dario0603/power_supply/Relazione/Relazione Costruzioni.odt

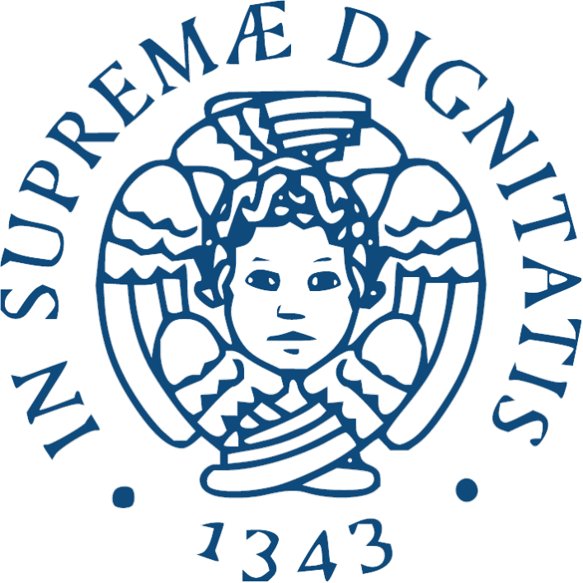
[picture p5: figure]

Università degli studi di Pisa

Dipartimento di ingegneria dell’informazione

Corso di laurea ingegneria elettronica

Progettazione di un alimentatore

da banco stabilizzato

Studenti:

Giorgio De Stefano

Dario Aliberti

Indice

Introduzione

- Presentazione del progetto
- Obbiettivi del lavoro

Analisi del circuito alimentatore

Analisi del circuito raddrizzatore

- Circuito raddrizzatore e filtro
- Raddrizzatore a doppia semi-onda
- Filtro capacitivo
- Calcolo capacità raddrizzatore a doppia semi-onda
- Dimensionamento filtro capacitivo
- Simulazione circuito raddrizzatore e filtro

Analisi del circuito regolatore

- Circuito regolatore con feedback di corrente
- Efficienza energetica
- Non idealità nel regolatore di tensione
- Modalità tracking
- Simulazione circuito regolatore di tensione
- Dimensionamento circuito regolatore di tensione

Dimensionamento del circuito alimentatore

- Alimentazioni ausiliarie
- Taratura circuito di tracking

Analisi del circuito di lettura di tensione e corrente

Voltmetro con fondo-scala variabile

- Voltmetro a partitore resistivo
- Voltmetro a guadagno variabile
- Confronto circuiti voltmetro

Amperometro con fondo-scala variabile

- Amperometro con convertitore corrente tensione
- Amperometro con resistore di shunt

Scelta circuiti di misura

- Dimensionamento voltmetro
- Dimensionamento amperometro

Taratura circuiti

- Taratura circuito voltmetro
- Taratura circuito amperometro

Analisi guasti e non idealità circuito

- Calcolo capacità di accoppiamento piste
- Analisi signal integrity
- Simulazioni signal integrity
- Compilazione FMEA

Conclusione

- Difficoltà incontrate
- Possibili migliorie di progetto
- Conclusioni

Analisi del circuito alimentatore

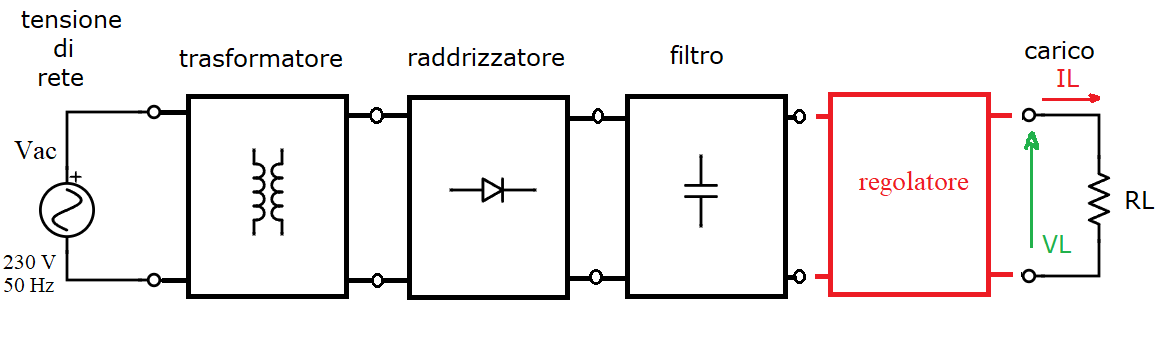
[picture p6: figure]

Il circuito dell’alimentatore è diviso in quattro blocchi principali

- Il trasformatore che si occupa di abbassare l’ampiezza della tensione sinusoidale di rete mantenendo costante la potenza elettrica in ingresso e in uscita.
- Il raddrizzatore che modifica la forma d’onda sinusoidale in uscita dal trasformatore in una forma d’onda unidirezionale (sempre positiva) pulsante.
- Il filtro che rimuove le componenti frequenziali indesiderate, quindi tutte le armoniche a frequenza non nulla.
- Il regolatore che prende in ingresso la tensione continua raddrizzata dal filtro e manda in uscita una tensione continua regolata in base alle esigenze dell’utente.

Analisi del circuito raddrizzatore

Circuito raddrizzatore e filtro

Il circuito raddrizzatore ha il compito di rendere unidirezionale una fonte di tensione alternata.

Esistono diversi tipi di raddrizzatori, tuttavia i più comuni sono due: il raddrizzatore a singola semi-onda e il raddrizzatore a doppia semi-onda.

Raddrizzatore a doppia semi-onda

Il raddrizzatore a doppia semi-onda è formato da quattro diodi che entrano in conduzione a coppie alterne in modo da far passare la corrente in un verso quando la tensione in ingresso è positiva e nel verso opposto quando è negativa.

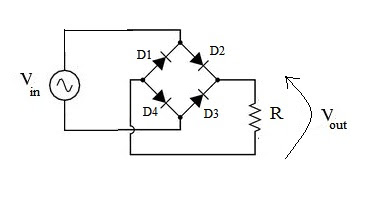
[picture p7: figure]

I diodi D2 e D4 entrano in conduzione quando Vin è positiva e supera la soglia di conduzione dei due diodi, quindi 2VDon ≈ 1.4V, i diodi D1 e D3 invece entrano in conduzione quando Vin è negativa e scende sotto il valore di 2VDon quindi quando Vin < -2VDon ≈ -1.4V.

Quando conducono i diodi D2 e D4 la corrente sul carico scorre in un verso, mentre quando conducono i diodi D1 e D3 la corrente scorre sul carico nel verso opposto in modo da avere una tensione sul carico sempre positiva (o negativa dipende da dove viene collocato il riferimento di massa).

alignl size 16 {stack { {V} rsub {o} = {V} rsub {i} − 2 {V} rsub {Don} ≃ {V} rsub {i} − 1.4 V ~ ~ ~ se {V} rsub {i} ≥ 2 {V} rsub {Don} } } newline
alignl size 16 { {stack { {V} rsub {o} = - {V} rsub {i} + 2 {V} rsub {Don} ≃ - {V} rsub {i} + 1.4 V ~ ~ ~ se {V} rsub {i} <= -2 {V} rsub {Don} } } } newline
alignl size 16 { {stack { {V} rsub {o} = 0 V ~ ~ ~ se -2 {V} rsub {Don} < {V} rsub {i} < 2 {V} rsub {Don} } } }

La forma d’onda del segnale Vout sarà quindi

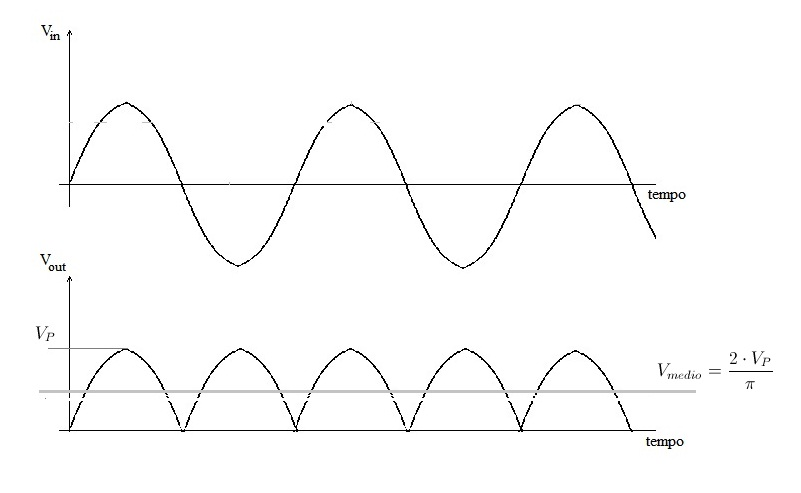
[picture p8: figure]

Il valor medio sarà all’incirca il doppio rispetto al raddrizzatore a singola semi-onda, infatti

size 16 { {V} rsub {m} = {int from {a} to {b} {left ({V} rsub {p} sin left (ω t right ) − {V} rsub {Don} right ) dt}} over {{2 π} over {ω}} ≃ {int from {0} to {{2 π} over {ω}} {{V} rsub {p} sin left (ω t right ) dt}} over {{2 π} over {ω}} = {left none {{− {V} rsub {p}} over {ω} cos left (ω t right )} over {{2 π} over {ω}} right rline} rsub {0} rsup {{2 π} over {ω}} = {2 {V} rsub {p}} over {π} }

Il valore efficace sarà invece

size 16 { V_eff = sqrt { { { int from { a } to { b } { (V_p sin ( %omega t ) - V_{ Don } ) ^ 2 dt } } } over { { 2 %pi } over %omega } } simeq
{ sqrt { int from { 0 } to { { 2 %pi } over %omega } { V_p^2 sin ( %omega t ) ^ 2 dt } over { { 2 %pi } over %omega } } } } newline
size 16 { V_eff simeq evaluate { V_p sqrt { { { %omega } over { 2 %pi } } cdot { { 2 %omega t - sin ( 2 %omega t ) } over { 4 %omega } } } } from { 0 } to { { 2 %pi } over %omega } =
{ V_p } over { sqrt { 2 }} }

quindi il fattore di forma complessivo sarà più grande rispetto al raddrizzatore a singola semi-onda.

size 16 { K_f = V_eff over V_m simeq { V_p over sqrt { 2 } } over { 2 V_p over %pi } = %pi over sqrt 2 simeq 2.22}

Filtro capacitivo

Il filtro capacitivo consiste in un filtro passa basso formato da un condensatore connesso in parallelo all’uscita del circuito raddrizzatore che ha il compito di caricarsi molto rapidamente, tramite i diodi del circuito raddrizzatore, e scaricarsi più lentamente possibile, sul carico.

Per il dimensionamento del filtro capacitivo bisogna scegliere una capacità abbastanza elevata da scaricarsi poco durante il periodo in cui la tensione raddrizzata è bassa, ma abbastanza piccola da non far scorrere troppa corrente sul circuito raddrizzatore durante le fasi di carica.

Calcolo capacità raddrizzatore a doppia semi-onda

Ipotizzando di trascurare l’impedenza di sorgente, la tensione d’uscita avrà, a regime, un andamento periodico.

All’interno di un periodo la tensione di uscita coinciderà con la tensione in ingresso nell’intervallo in cui il diodo conduce e coinciderà con la tensione di scarica del condensatore quando il diodo è interdetto.

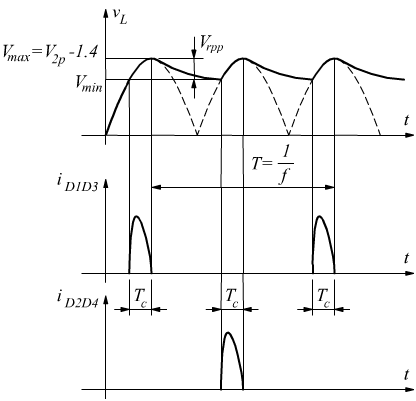
[picture p9: figure]

Ipotizzando che il carico sia una resistenza RL otterremo che durante la scarica del condensatore la tensione sarà.

size 16 { v ( t ) = V_M e^{ - { { t - t_0 } over { R_L C } } } }

chiamo Vrpp la tensione di ripple, ovvero la differenza tra VM e la tensione minima raggiunta dal condensatore durante la scarica.

size 16 { V_rpp = V_M - V_min = V_M - v( T over 2 + t_0 ) =
V_M - V_M e^{ - { T over { 2 R_L C } } } = V_M ( 1 - e^{ - { T over { 2 R_L C } } } ) }

imponendo una certa tensione di ripple massima possiamo calcolare il minimo valore di C che ci permette di soddisfare questa condizione

size 16{ e^{ - T over { 2 R_L C } } = 1 - V_rpp over V_M ~ ~ drarrow ~ ~
C = { T over { 2 R_L } } cdot { 1 over { ln left ( {1 over { 1 - V_rpp over V_M} } right ) } } }

ipotizzo che Vrpp << VM visto che l’obbiettivo del filtro è avere in uscita una tensione continua, quindi con Vrpp il più piccolo possibile, e applico lo sviluppo in serie di Taylor al prim’ordine alla funzione logaritmica per rendere la formula più maneggiabile.

size 16{ { ln( 1 over { 1 - x } ) } sim
{ { d } over { dx } { ln( 1 over { 1 - x } )
left none right rline_{ x = 0 } cdot x = x } } } newline
size 16{ C = { T over { 2 R_L } } cdot { 1 over { ln left ( {1 over { 1 - V_rpp over V_M} } right ) } sim { T over { 2 R_L } } cdot { V_M over V_rpp } } }

Noto che il termine VM / RL è la corrente massima assorbita dal carico, quindi la formula diventa

size 16 { C sim { T over { 2 V_rpp } } cdot I_M }

Dimensionamento filtro capacitivo

Per il nostro progetto vogliamo che l’alimentatore sia in grado di erogare una corrente massima di 5A e una tensione in uscita variabile tra 0V e 20V.

La tensione sinusoidale in ingresso al raddrizzatore arriva dal secondario di un trasformatore a 25V di tensione efficace, 50Hz.

Per non avvicinarci troppo al valore di tensione massima in uscita, ovvero 20V scegliamo un ripple abbastanza contenuto, per esempio 3,5V

Da questi dati possiamo calcolare il valore di capacità di livellamento con i due tipi di raddrizzatori.

size 16 { I_M simeq 5A } newline
size 16 { V_rpp = 2,5V } newline
size 16 { T = 1 over f simeq 1 over { 50 Hz } simeq 20 ms } newline

Nel caso avessi utilizzato un raddrizzatore a singola semi-onda avrei dovuto inserire un condensatore di valore

size 16 { C sim T over V_rpp cdot I_M simeq 28571uF }

Questi valori di capacità sono difficili da raggiungere, visto che bisognerebbe utilizzare dei banchi di condensatori elettrolitici in parallelo, quindi una riduzione di capacità significa meno spazio occupato su PCB e meno soldi spesi per l’acquisto di condensatori, per questo è stato scelto un raddrizzatore a doppia semi-onda, infatti nel caso del raddrizzatore a doppia semi-onda mi basta inserire un condensatore di valore

size 16 { C sim T over { 2 V_rpp } cdot I_M simeq 14286uF }

più piccolo rispetto a quello del raddrizzatore a singola semi-onda.

Simulazione circuito raddrizzatore e filtro

Per fare un calcolo approssimato della massima corrente che scorre nel diodo nel caso del raddrizzatore a singola semi-onda si può risolvere l’equazione di secondo grado che eguaglia la funzione di scarica del condensatore con la funzione della tensione raddrizzata per calcolare il tempo di commutazione del diodo TC

size 16 { V_M - V_rpp over T cdot t = V_M cos( { 2 %pi } over T t )sim
V_M ( 1 - { {4 %pi^2 } over { T^2 } } cdot { { (t-T)^2 } over 2 } ) }

risolvendo l’equazione si ottiene che

size 16 { -T_C = T-t sim { { V_rpp over V_M - sqrt{ { V_rpp^2 } over { V_M^2 } + 8 cdot { V_rpp over V_M %pi^2 } } } } over { { 4 %pi } over T } simeq -5,073 ms }

avendo TC posso avere una stima di quanto valgano le correnti di picco sui diodi dei raddrizzatori

size 16 { I_{Dmax singola semionda} = I_M T over T_C simeq 19,71 A } newline
size 16 { I_{Dmax doppia semionda} = I_M T over {2 T_C } simeq 9,85 A }

i valori ottenuti ovviamente sono una stima, tuttavia sono utili per farsi un’idea degli ordini di grandezza delle correnti a cui saranno sottoposti i componenti.

Simulazioni fatte con un generatore sinusoidale a 35V picco picco 50Hz, una resistenza di carico di 5Ω e un condensatore da 14286uF per il raddrizzatore a doppia semi-onda e da 28571uF per il raddrizzatore a singola semi-onda

- Grafico rosso corrente nel diodo con raddrizzatore singola semi-onda
- Grafico verde corrente nei diodi con raddrizzatore doppia semi-onda

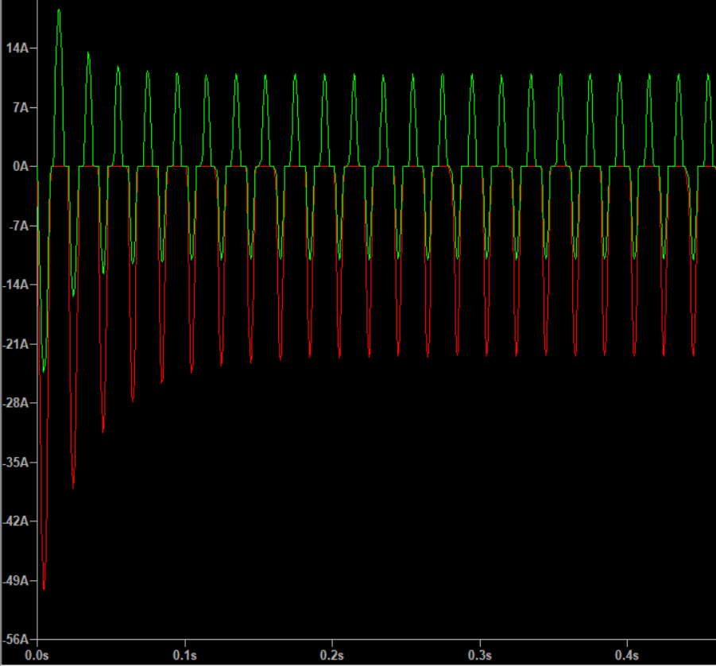
[picture p10: figure]

Si nota che all’accensione i condensatori si suppongono scarichi, quindi ho dei picchi di corrente molto elevati

- 50,12A nel raddrizzatore a singola semi-onda
- 24,5A nel raddrizzatore a doppia semi-onda

poi a regime i picchi si stabilizzano a valori sensibilmente più bassi

- 22,45A nel raddrizzatore a singola semi-onda
- 10,97A nel raddrizzatore a doppia semi-onda
- Grafico blu tensione sul carico raddrizzatore singola semi-onda
- Grafico verde tensione sul carico raddrizzatore doppia semi-onda

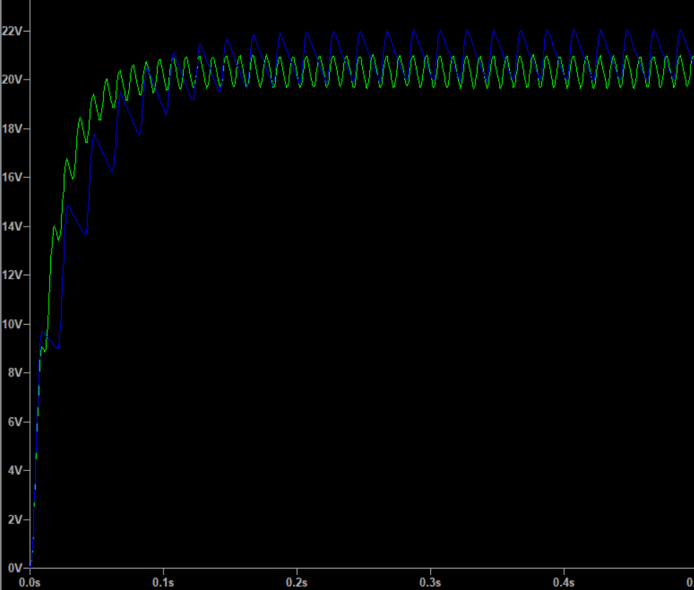
[picture p11: figure]

Si nota come il valor medio delle tensioni a regime si assesta su

- 20,90V nel raddrizzatore a singola semi-onda
- 20,25V nel raddrizzatore a doppia semi-onda

Con un ripple che vale all’incirca

- 2,2V nel raddrizzatore a singola semi-onda
- 1,3V nel raddrizzatore a doppia semi-onda

Analisi del circuito regolatore

come circuito regolatore è stato utilizzato un circuito molto comune, ovvero il circuito ad amplificatore di errore e transistor di passo

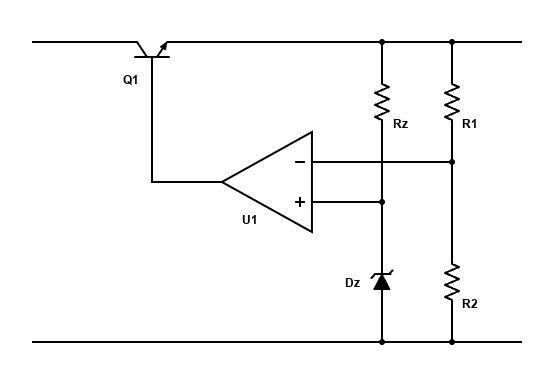
[picture p12: figure]

Questo circuito è formato da un amplificatore operazionale che ha sul pin non invertente un diodo zener polarizzato tramite la resistenza RZ il solo scopo di quel diodo è quello di fornire una tensione di riferimento costante VZ sulla quale si baserà la regolazione di tensione del circuito, infatti se ipotizziamo la corrente assorbita dall’amplificatore operazionale trascurabile avremo che

size 16{ I_Z = { V_O - V_Z } over R_Z ~ ~ se ~ ~ V_O > V_Z}

quindi per la nostra trattazione consideriamo VZ costante.

Sul pin invertente dell’amplificatore operazionale abbiamo invece un partitore di tensione formato dalle resistenze R1 e R2 connesso tra massa e la tensione di uscita VO.

Verifichiamo che il circuito sia retroazionato e troviamo una relazione tra Vin e VO.

Chiamo Vb la tensione sulla base del BJT Q1, che coincide con la tensione di uscita dell’amplificatore operazionale.

size 16{ V_b = A_Vo ( V_Z - R_2 over { R_2 + R_1 } cdot V_O ) }

Se Vb > VO + VBEon il BJT Q1 entra in conduzione e quindi si può ipotizzare che VBE sia costante e pari a 0,7V, quindi

size 16{ V_O simeq V_b - V_BEon simeq V_b - 0,7V } newline
size 16{ V_O + V_BEon = A_Vo cdot (V_Z - R_2 over { R_2 + R_1 } cdot V_O) } newline
size 16{ V_O = { A_Vo cdot V_Z - V_BEon } over { 1 + A_Vo cdot { {R_2} over { R_2 + R_1 } } } }

visto che il guadagno ad anello aperto di un amplificatore operazionale Avo è molto grande (10⁵ – 10⁷) posso fare il limite di VO per Avo che tende all’infinito per trovare una formula approssimata ma più semplice di VO

size 16{ lim from{ A_Vo rightarrow infinity } V_O = lim from{ A_Vo rightarrow infinity } { { A_Vo cdot V_Z - V_BEon } over { 1 + A_Vo cdot { {R_2} over { R_2 + R_1 } } } } = V_Z ( 1 + R_1 over R_2 ) }

In questa configurazione voglio che il BJT T1 lavori in zona attiva diretta in maniera tale che la corrente sul carico sia sempre

size 16{ I_O = ( %beta_f + 1) I_b }

dove Ib è fornita dall’amplificatore operazionale.

Per far si che il BJT lavori in zona attiva diretta bisogna soddisfare due condizioni:

- Vce > Vcesat ~ 0,1V
- Ib > 0A

size 16{ V_ce = V_i - V_O > V_cesat ~ ~ drarrow ~ ~
V_i > V_cesat + V_O sim V_cesat + 0,1V}

quindi bisogna fare in modo tale che la tensione in ingresso al regolatore sia più grande della massima tensione in uscita desiderata di almeno

Vcesat ~ 0,1V.

La corrente Ib > 0A è una condizione sempre verificata in caso di carichi resistivi.

Nel caso Ic < 0A vorrebbe dire che VO > Vi quindi avrei che Vce < 0V e che Ib < 0A, quindi se Vce < -Vcesat ~ -0,1V il BJT Q1 lavora in zona attiva inversa quindi βr ~ 2 è molto piccola.

Se il BJT T1 lavora in zona attiva inversa l’amplificatore operazionale, che eroga una corrente IO = ( βr + 1)Ib , si ritrova a dover erogare una corrente di base di grandezza comparabile alla corrente di collettore.

Per evitare questo problema è stato messo nel circuito un diodo tra collettore e emettitore del BJT in modo che se la tensione di uscita super la tensione di ingresso di un valore pari a VDon ~ 0,7V, il diodo entra in conduzione.

Sapendo che il BJT lavora in zona attiva diretta, sapendo la massima corrente che scorre sul carico e la massima corrente erogabile dall’amplificatore operazionale posso calcolare il minimo valore di βf che soddisfa queste esigenze, inoltre sapendo anche la massima Vce ai capi del BJT posso sapere anche la massima potenza dissipata.

Il problema di questo circuito è che non c’è modo di limitare la corrente erogata sul carico, quindi per fare questo bisognerà modificare leggermente il circuito aggiungendo un feedback di corrente.

Circuito regolatore con feedback di corrente

Il feedback di corrente consiste in un amplificatore differenziale connesso ai capi di una resistenza di piccolo valore detta resistenza di shunt.

La resistenza di shunt è connessa in serie al carico subito dopo il BJT di regolazione della tensione, in modo tale che la corrente che scorre sul carico è la stessa, a meno di correnti assorbite dagli amplificatori operazionali, dal partitore resistivo e dallo zener (correnti molto piccole), di quella che scorre sulla resistenza di shunt.

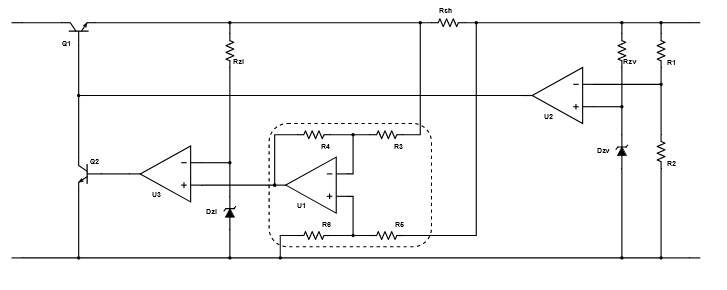
[picture p13: figure]

L’amplificatore operazionale U1 legge la differenza di potenziale ai capi di Rsh quindi se chiamo Vo1 la tensione in uscita dell’amplificatore operazionale U1, ottengo che

size 16{ V_O1 = R_sh I_O cdot G_d }

con Gd il guadagno differenziale dell’amplificatore differenziale U1.

La relazione ingresso uscita dell’amplificatore differenziale si trova con il metodo della sovrapposizione degli effetti.

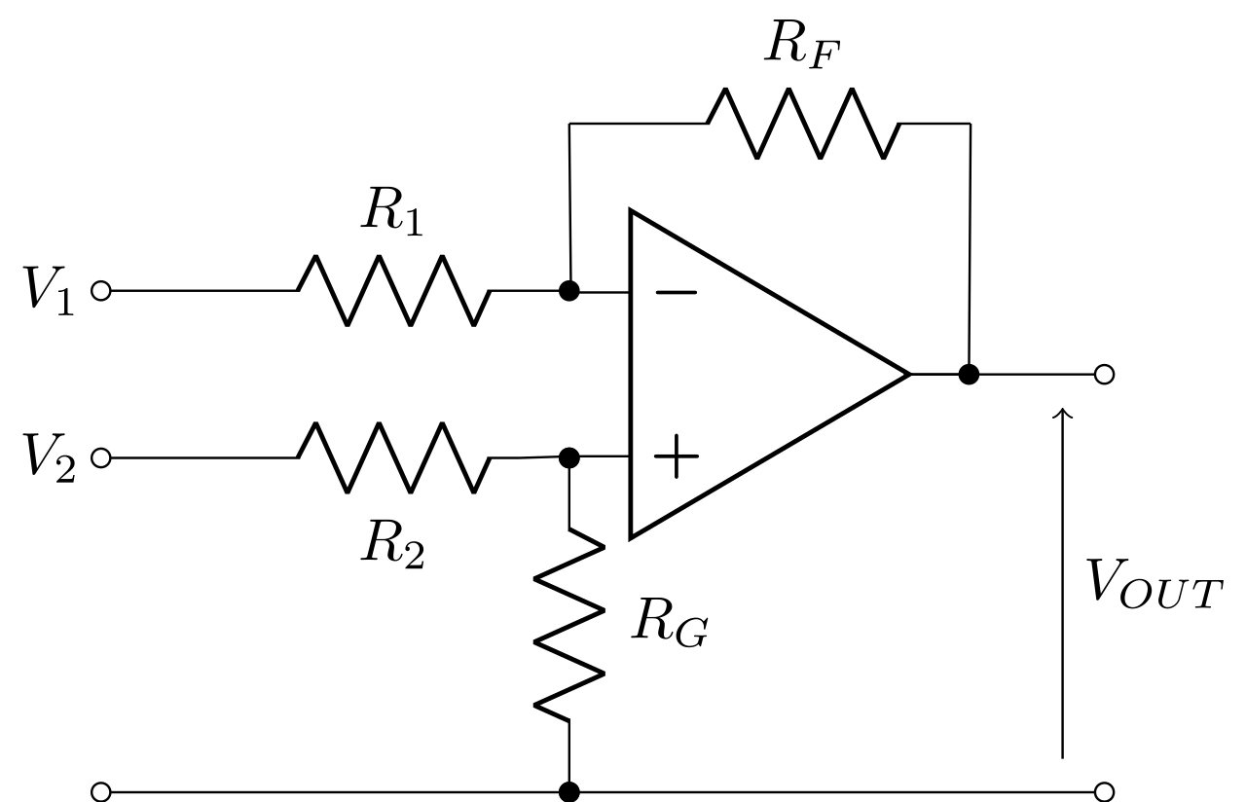
[picture p14: figure]

size 16{ V_O = V_2 cdot { R_G over { R_2 + R_G } } cdot { ( 1 + R_F over R_1 ) } - V_1 cdot { R_F over R_1 } }

Visto che utilizziamo l’amplificatore differenziale per la misura della differenza di potenziale ai capi della resistenza Rsh ci interessa analizzare il guadagno differenziale e il guadagno a modo comune dell’amplificatore differenziale, per fare questo si definisce

- Vd = V2 – V1 tensione differenziale
- Vc = ( V1 + V2 )/2 tensione di modo comune
- Gd guadagno differenziale
- Gc guadagno di modo comune

date queste definizioni possiamo scrivere la formula di sopra in questo modo

size 16{ V_O = V_d cdot G_d + V_c cdot G_c =
( V_2 - V_1 ) cdot G_d + ( { V_2 + V_1 } over 2 ) cdot G_c =
V_2 cdot ( G_c over 2 + G_d ) + V_1 cdot ( G_c over 2 - G_d ) } newline
size 16{ G_2 = G_c over 2 + G_d ~ ~ G_1 = G_c over 2 - G_d } newline
size 16{ G_c = G_2 + G_1 = R_G over {R_2 + R_G } - { R_F over R_1 }cdot{ R_2 over {R_2 + R_G } } ~ ~
G_d = { G_2 - G_1 } over 2 = { R_G over { 2 cdot ( R_2 + R_G ) } + { R_F over { 2R_1 } cdot { { 2R_G + R_2 }over{ R_G + R_2 } } } } }

noi vogliamo annullare il guadagno di modo comune, quindi dobbiamo porlo uguale a zero

size 16{ G_c = 0 ~ ~ drarrow ~ ~ { R_G - R_F over R_1 cdot R_2 } = 0 ~ ~ drarrow ~ ~
R_G R_1 = R_F R_2 }

per semplificare i calcoli poniamo RG = RF e R1 = R2 in questo modo il guadagno differenziale diventa

size 16{ G_d = R_G over R_2 = R_F over R_1}

il blocco che è stato aggiunto è un comparatore in cascata ad un amplificatore differenziale, lo scopo del comparatore è quello di confrontare la tensione di riferimento imposta dallo zener Dzi con la tensione ai capi della resistenza di shunt, se la tensione di riferimento è maggiore della tensione in uscita dal differenziale, l’uscita dell’amplificatore diminuisce, mentre se la tensione di riferimento è minore della tensione in uscita dal differenziale, l’uscita dell’amplificatore aumenta.

Il comparatore è connesso alla base del BJT Q2 che entra in conduzione quando Vbe2 > Vbeon ~ 0,7V facendo scorrere corrente tra collettore e emettitore, verso massa.

L’idea è che l’amplificatore operazionale U2 può erogare una quantità limitata di corrente, che se Q2 è interdetto finisce tutta nella base di Q1 permettendo così lo scorrimento di corrente sul carico.

Quando Q2 entra in conduzione, la corrente erogata da U2 scorre nella base di Q1 e, tramite il collettore di Q2, a massa, quindi se ad un certo punto U2 non è più in grado di erogare abbastanza corrente, la corrente che dovrebbe fluire nella base di Q1 comincia a fluire gradualmente nel collettore di Q2 verso massa, riducendo così la corrente sul carico fino al valore imposto dalla tensione di riferimento del comparatore.

Calcoliamo ora la corrente che viene limitata dal limitatore, per farlo bisogna capire quando si accende il transistor Q2.

Il transistor Q2 non interviene finché la tensione di riferimento sul pin invertente del comparatore non scende sotto il valore di tensione sul pin non invertente, che è la tensione in uscita dall’amplificatore differenziale.

La corrente non viene limitata fino a che non si attiva Q2 quindi per calcolare il range in cui la corrente non viene limitata bisogna analizzare quando la tensione sul pin invertente è maggiore della tensione sul pin non invertente.

size 16{ V^{-{}} >= V^{+{}} ~ ~ drarrow ~ ~ V_Z >= R_sh I_O G_d ~ ~ drarrow ~ ~ I_O <= V_Z over { R_sh G_d } }

quindi la corrente sul carico è limitata al valore

size 16{ I_Omax = V_Z over { R_sh G_d } }

Efficienza energetica

Definiamo il rendimento energetico come

size 16{ %eta = P_O over P_tot = P_O over { P_O + P_persa } }

dove PO è la potenza fornita al carico, Ptot è la potenza assorbita dall’alimentatore e Ppersa è la potenza dissipata sui componenti del circuito.

Possiamo calcolare la potenza persa e la potenza assorbita come

size 16{ P_persa = (V_i - V_O) cdot I_O } newline
size 16{ P_O = V_O I_O }

e quindi il rendimento complessivo dell’alimentatore diventa pari a

size 16{ %eta = { V_O I_O }over{ V_i I_O - V_O I_O + V_O I_O } =
V_O over V_i }

queste tipologie di alimentatori non hanno rendimenti molto elevati, infatti considerando Vi = 25V

size 16{ caso migliore ~ ~ V_O = V_i - V_{caduta sul BJT} simeq
V_i - 0,1V ~ ~ drarrow ~ ~ %eta simeq { V_i - 0,1V } over V_i < 0,996 }newline
size 16{ caso peggiore ~ ~ V_O simeq 0V ~ ~ drarrow ~ ~ %eta simeq 0}

il rendimento varia molto in funzione della tensione in uscita al carico.

Non idealità nel regolatore di tensione

le non idealità del circuito che ne influenzano il comportamento sono

- Le tensioni di offset degli amplificatori operazionali
- Le correnti di perdita degli amplificatori operazionali
- Il rumore generato dagli amplificatori operazionali

La tensione di offset ha effetto su tutti i componenti del circuito che contengono amplificatori operazionali.

Per prima cosa analizziamo l’amplificatore operazionale di errore

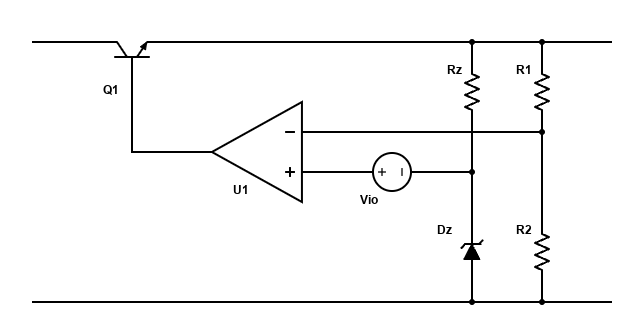
[picture p15: figure]

in questo caso si nota come Vio sia connesso in serie alla tensione di riferimento generata con lo zener, quindi il suo effetto è lo stello che avrei se aumentassi (o diminuissi) la tensione di riferimento di un valore Vio

size 16{ lim from{ A_Vo rightarrow infinity } V_O = lim from{ A_Vo rightarrow infinity } { { A_Vo cdot (V_Z + V_io) - V_BEon } over { 1 + A_Vo cdot { {R_2} over { R_2 + R_1 } } } } = (V_Z + V_io) cdot ( 1 + R_1 over R_2 ) }

In questo stadio si nota che la tensione di offset viene amplificata per un fattore, quindi va compensata questa variazione regolando la tensione di riferimento di conseguenza.

Lo stesso discorso vale per il comparatore connesso al transistor Q2 che regola il limite massimo di corrente, quindi

size 16{ I_Omax = { V_Z + V_io } over { R_sh G_d } }

Per l’amplificatore differenziale connesso in ingresso al comparatore dobbiamo analizzare il comportamento di Vio applicando la sovrapposizione degli effetti.

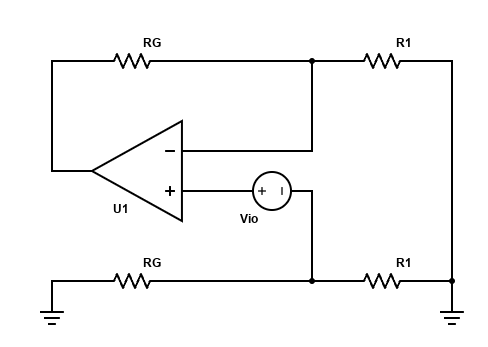
[picture p16: figure]

Dal disegno si nota che, trascurando la corrente assorbita dall’amplificatore operazionale, abbiamo un amplificatore in configurazione non invertente

size 16{ V_O = V^{+{}} cdot (1 + R_G over R_1) =
(V_io + (R_1 /{}/{} R_G) cdot I^{+{}}) cdot (1 + R_G over R_1) simeq
V_io cdot (1 + R_G over R_1) }

quindi questo stadio è critico per la regolazione in corrente poiché la tensione di offset viene amplificata, in questo caso si può compensare questo errore in due modi

- Si varia la tensione di riferimento del comparatore a valle dell’amplificatore
- Si utilizza un amplificatore a basso offset

Analizziamo adesso l’effetto delle correnti di polarizzazione

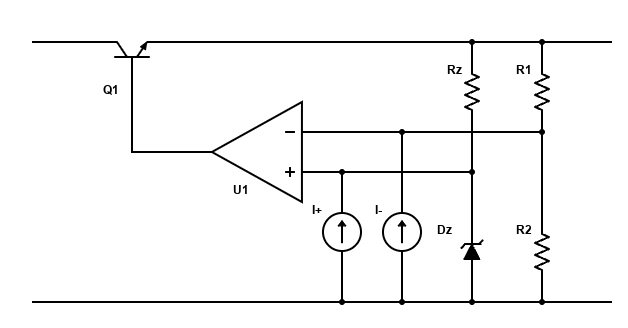
[picture p17: figure]

Le correnti di polarizzazione nel circuito del regolatore di tensione influiscono facendo scorrere corrente nello zener e corrente nel partitore resistivo, quindi

size 16{ V^{+{}} simeq V_z } newline
size 16{ V^{-{}} = V_O R_2 over { R_1 + R_2 } + (R_2 /{}/{} R_1) I^{-{}}}

la tensione sul pin non invertente non varia molto, poiché essendo la corrente di zener molto maggiore della corrente di polarizzazione dell’amplificatore la tensione VZ rimane pressoché invariata, tuttavia ho un contributo non trascurabile relativo al partitore R1 R2.

Quindi l’effetto sulla tensione di uscita sarà

size 16{ lim from{ A_Vo rightarrow infinity } V_O = lim from{ A_Vo rightarrow infinity } { { A_Vo cdot (V_Z - (R_2 /{}/{} R_1) I^{-{}} ) - V_BEon } over { 1 + A_Vo cdot { {R_2} over { R_2 + R_1 } } } } = (V_Z - (R_2 /{}/{} R_1) I^{-{}}) cdot ( 1 + R_1 over R_2 ) }

Gli effetti delle correnti di polarizzazione nell’amplificatore differenziale sono relative alle resistenze di feedback

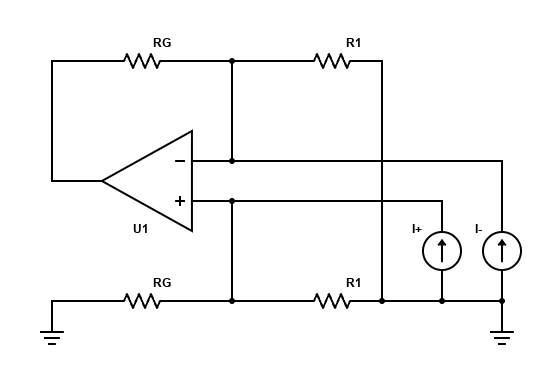
[picture p18: figure]

sempre utilizzando la sovrapposizione degli effetti si trova che il loro contributo è

size 16{ V_O = I^{+{}} (R_1 /{}/{} R_G) cdot (1 + R_G over R_1) -
I^{-{}} cdot R_G }

Lo stadio a valle dell’amplificatore differenziale è un comparatore che ha sul pin non invertente l’uscita del differenziale, quindi la corrente I⁺ viene assorbita da lui, mentre sul piedino invertente ha collegato un diodo zener

che, per lo stesso discorso del circuito del regolatore di tensione, risente in maniera trascurabile di questo effetto, quindi si può dire che sul comparatore non influiscono sensibilmente gli effetti delle correnti di polarizzazione.

Considerando i parametri reali degli amplificatori operazionali la corrente massima e la tensione in uscita valgono quindi

size 16{ tensione di uscita ~ ~ V_O = (V_Z - (R_2 /{}/{} R_1) I^{-{}} + V_io) cdot ( 1 + R_1 over R_2 )} newline
size 16{ corrente massima ~ ~ I_Omax = { V_Z + V_io - V_io cdot (1+ R_G over R_1) - I^{+{}} (R_1 /{}/{} R_G) cdot (1 + R_G over R_1) + I^{-{}} cdot R_G}over{R_sh G_d} }

Modalità tracking

Una funzionalità comoda da avere per il regolatore di tensione è quella di disporre dei pin esterni di tracking, quando l’alimentatore è in modalità tracking la tensione imposta in uscita sarà pari al valore di tensione ai capi dei pin di tracking.

La modalità tracking può essere utilizzata in tutti gli ambiti in cui ho bisogno di due tensioni uguali in modulo e segno, ma anche quando ho bisogno di due tensioni uguali in modulo ma di segno opposto, il nostro alimentatore tuttavia è in grado di disporre in uscita tensioni positive, se quindi in ingresso ai pin di tracking fosse applicata una tensione negativa, l’amplificatore di errore saturerebbe negativamente portando la tensione in uscita a zero.

Per evitare questo i pin di tracking sono connessi ad un raddrizzatore a doppia semi-onda che ne estrapola il modulo.

Per cambiare modalità operativa si utilizza un relè DPDT controllato elettronicamente dalla scheda di controllo, che connette il pin invertente dell’amplificatore di errore direttamente a VO e il pin non invertente viene connesso alla tensione letta sui pin di tracking, così facendo con il metodo del cortocircuito virtuale possiamo calcolare la tensione VO di uscita

size 16{ A_vo (V_tracking - V_O) = V_O - V_BEon }

facendo tendere Avo all’infinito otteniamo che in modalità tracking

size 16{ V_O = V_tracking }

Il relè DPDT è un interruttore elettromeccanico formato da una bobina e due deviatori, quando passa corrente nella bobina viene creato un campo magnetico che fa cambiare la posizione dei due deviatori contemporaneamente.

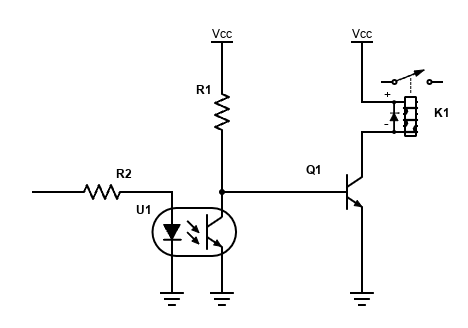
[picture p19: figure]

Nella scheda di controllo ci sarà un microcontrollore che piloterà il relè, tuttavia i relè hanno delle correnti di mantenimento piuttosto alte ed è difficile che un microcontrollore raggiunga quelle specifiche, quindi per controllarlo si utilizza un BJT in configurazione emettitore comune, dove al posto della resistenza di collettore c’è la bobina del relè da controllare.

Un altro problema tipico nel controllo dei relè e quello della corrente di ricircolo della bobina,

infatti la bobina, essendo un induttore, quando viene scollegata dalla rete elettrica tramite il BJT, per il principio di inerzialità dell’induttore tende a far scorrere tanta corrente quanta ce n’era prima dell’interruzione del circuito tramite il BJT, ma essendo il BJT interdetto non può scorrere corrente quindi la tensione ai capi della bobina aumenta rischiando di danneggiare il transistor.

Per risolvere questo problema si inserisce un diodo in antiparallelo alla bobina chiamato diodo di ricircolo che permette la scarica della corrente dell’induttore sul diodo e non sul transistor.

Come protezione per il microcontrollore si usa un isolatore ottico per pilotare il BJT in maniera tale che se la giunzione base collettore si dovesse rompere per qualche motivo, il microcontrollore sarebbe elettricamente isolato dal circuito e non ne rimarrebbe danneggiato.

Il diodo di ricircolo deve poter sopportare una corrente superiore a

size 16{ I_D > V_{bobina relè} over { R_{bobina relè} + R_{diodo} } simeq 25A }

per un breve periodo di tempo e una tensione pari a circa il doppio della tensione di controllo della bobina.

Simulazione circuito regolatore di tensione

Per la simulazione del circuito abbiamo variato la Vzv da 0V a 4V e analizzato il comportamento della tensione di uscita.

Per la prima simulazione è stato seguito un andamento a rampa, per la seconda simulazione è stato inviato un gradino.

Risposta alla rampa

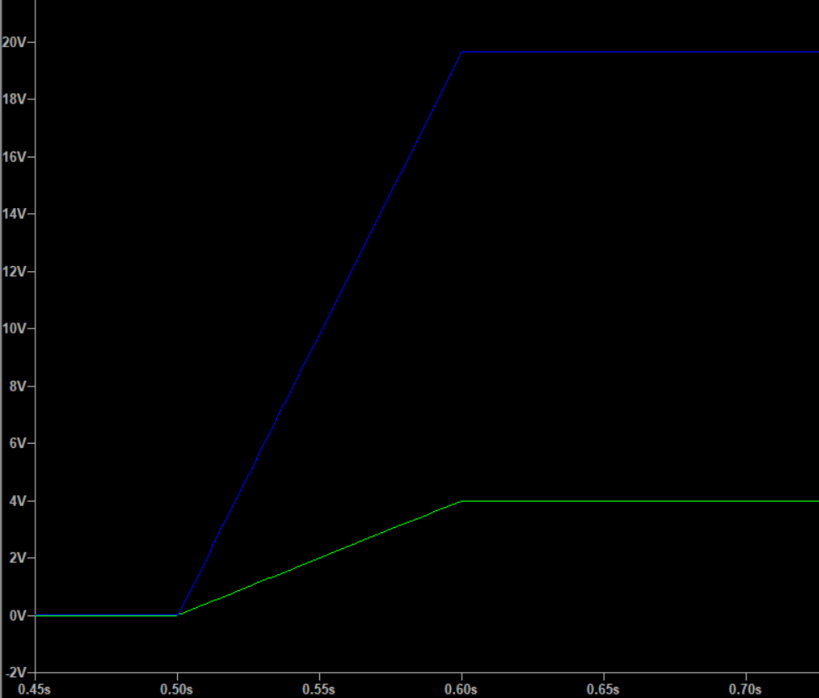
[picture p20: figure]

Una rampa da 0V a 4V di durata 100ms viene simulata con un andamento teorico perfetto della tensione di uscita

Risposta al gradino

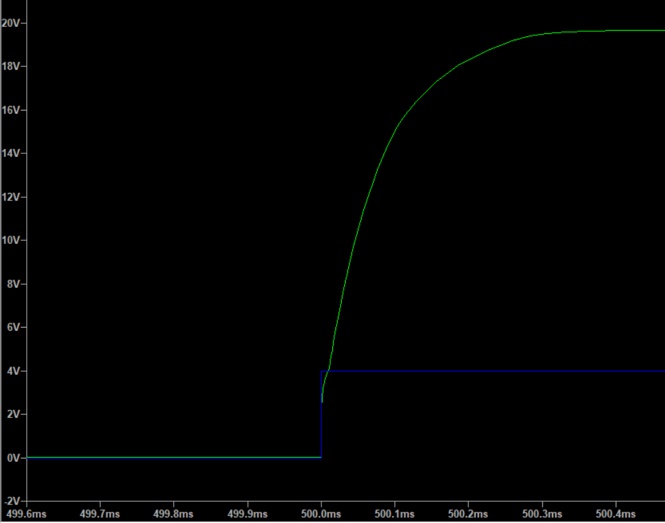
[picture p21: figure]

Dalla risposta al gradino si nota che per attestarsi la tensione in uscita ha bisogno di un tempo τ ~ 400us.

Naturalmente la simulazione potrebbe comunque dare risultati differenti dal caso reale.

Dimensionamento circuito regolatore di tensione

La tensione e la corrente limite vengono regolate dalla scheda di controllo variando la tensione di riferimento che va agli amplificatori (tensione che nell’analisi del circuito è stata imposta da uno zener).

La tensione di riferimento della scheda di controllo è regolata tra 0V a 4V (poiché è generata da un DAC che ha queste limitazioni costruttive), quindi Vzv e Vzi , che sono le tensioni di riferimento inviate dalla scheda di controllo, devono essere associate a dei valori di tensione e corrente in uscita, vogliamo quindi che

- quando Vzv = 0V ; VO = 0V
- quando Vzi = 0V ; IOmax = 0A
- quando Vzv = 4V ; VO = 20V
- quando Vzi = 4V ; IOmax = 5A

partiamo dal dimensionamento del circuito regolatore di tensione.

Sappiamo che la formula ideale della tensione di uscita in funzione della tensione di riferimento è

alignl size 16{ V_O = V_Zv cdot ( 1 + R_1 over R_2 ) } newline
alignl size 16{ V_Zv = 0V ~ ~ drarrow ~ ~ V_O = 0V } newline
alignl size 16{ V_Zv = 4V ~ ~ drarrow ~ ~ V_O = 20V ~ ~ drarrow ~ ~ R_1 over R_2 =
V_O over V_Zv - 1 simeq 4 ~ ~ drarrow ~ ~ R_1 simeq 4 cdot R_2}

abbiamo trovato una relazione per il valore di R2 e R1, adesso cerchiamo dei valori di resistenze che riducono l’errore dato dalle correnti di polarizzazione degli amplificatori operazionali, ma che non facciano scorrere troppa corrente sul ramo R1, R2 in modo da contenere gli effetti delle correnti di perdita.

Analizzando la tensione di uscita reale, quindi considerando i parametri reali degli operazionali, notiamo che il contributo della corrente di polarizzazione è moltiplicato per il parallelo tra R1 e R2

size 16{
V_O = (V_Z - (R_2 /{}/{} R_1) I^{-{}} + V_io) cdot ( 1 + R_1 over R_2 )}

i valori tipici delle correnti di polarizzazione vanno da 1 nA a 1 uA, quindi considerando il caso peggiore possiamo considerare la I⁻ pari a 10uA.

Per mantenere l’errore contenuto consideriamo che il termine relativo alle correnti di polarizzazione debba essere minore del 0,1% della tensione massima in uscita dall’alimentatore, quindi

size 16{ (R_2 /{}/{} R_1)I^{-{}} < V_Omax cdot 0,001 = 0,02V ~ ~
drarrow ~ ~ (R_2 /{}/{} R_1) < { V_Omax cdot 0,001 }over{I^{-{}} }
simeq 2k %OMEGA }

sapendo le condizioni che devono soddisfare le due resistenze, è stata scelta la coppia di valori commerciali di resistenze che più si avvicina a rispettarle, ovvero

size 16{ R_1 = 4,7k %OMEGA ~ ~ R_2 = 1,2k %OMEGA}newline
size 16{ 1+R_1 over R_2 simeq 4,9167 }newline
size 16{ R_1 /{}/{} R_2 simeq 956 %OMEGA < 2 k %OMEGA }

Per quanto riguarda il limitatore di corrente, partiamo con il dimensionamento della resistenza di shunt, visto che si trova in serie con l’uscita dell’alimentatore, la caduta ai suoi capi deve essere il più ridotta possibile, infatti

size 16{ V_O = V_i - V_ce - V_Rsh = V_i - V_ce - R_sh I_O }

visto che la corrente massima sappiamo quanto vale, se trascuriamo la Vce, sapendo il valore massimo di VO e il valore di Vi possiamo calcolare il massimo valore di Rsh.

size 16{ R_shmax simeq { V_i - V_O } over { I_Omax } simeq {25V-20V} over {5A} simeq 1 %OMEGA }

Il valore di Rsh calcolato non considera il ripple di 3,5V scelto durante il dimensionamento del raddrizzatore, quindi il valore massimo di Rsh diventa

size 16{ R_shmax simeq { V_i - V_O - V_rpp } over { I_Omax } simeq {25V-20V - 3,5V} over {5A} simeq 0,3 %OMEGA }

quindi il valore di resistenza che possiamo scegliere diminuisce di molto.

Il valore della resistenza di shunt va poi moltiplicato per la corrente che scorre sul carico per ottenere la tensione che viene letta dall’amplificatore differenziale e amplificata per un guadagno Gd, visto che la tensione letta ai capi della resistenza di shunt va poi confrontata con la tensione di riferimento per effettuare la limitazione di corrente, la tensione in uscita dall’amplificatore differenziale dovrà avere comparabile con essa.

size 16 { I_Omax = { V_Z + V_io - V_io cdot (1+ R_G over R_1) - I^{+{}} (R_1 /{}/{} R_G) cdot (1 + R_G over R_1) + I^{-{}} cdot R_G}over{R_sh G_d} }

se consideriamo la formula reale della corrente massima si nota che i termini Vio e I⁺ sono moltiplicati per dei fattori proporzionali al rapporto RG / R1 che è proprio il guadagno Gd dell’amplificatore differenziale, quindi la formula si può riscrivere in questo modo

size 16 { I_Omax = { V_Z + V_io - V_io cdot (1+ G_d) - I^{+{}} (R_1 /{}/{} R_G) cdot (1 + G_d) + I^{-{}} cdot G_d R_1}over{R_sh G_d} }

quindi per ridurre al minimo i parametri parassiti dell’amplificatore differenziale conviene ridurre al minimo il guadagno Gd.

Visto che al denominatore ho il prodotto Gd Rsh diminuire al massimo Gd significa aumentare al massimo Rsh mantenendo comunque un margine di tolleranza, la Rsh scelta è quindi

size 16{ R_sh = 0,2 %OMEGA }

si nota che il valore è abbastanza piccolo, per questi valori infatti le resistenze dei contatti potrebbero non essere trascurabili e visto che il circuito di controllo e il circuito di alimentazione sono separati bisogna fare in maniera tale che la tensione letta dall’amplificatore operazionale differenziale, che contiene l’informazione della corrente che scorre sul carico debba arrivare al circuito di controllo.

Nel circuito di controllo sarà presente la resistenza di shunt e l’amplificatore differenziale in modo che i contatti saranno posti in serie alla resistenza di shunt, tuttavia l’amplificatore differenziale leggerà la tensione direttamente ai capi della resistenza di shunt rimuovendo così l’errore relativo ai contatti del circuito, tutte le elaborazioni di segnale atte alla corretta lettura della corrente sul carico vengono fatte quindi sul circuito di controllo e la corrente letta e moltiplicata per il corretto guadagno viene inviata dal circuito di controllo al circuito dell’alimentatore.

L’analisi del circuito di controllo verrà fatta più avanti, per adesso continuiamo il dimensionamento del circuito sapendo che il coefficiente moltiplicativo associato alla corrente che scorre sul carico è

size 16{ G_d R_sh simeq 0,2 %OMEGA }

quindi la corrente massima sul carico sarà

size 16{ I_Omax = V_Zi over { G_d R_sh } simeq V_Zi over { 0,2 %OMEGA } }

e visto che la tensione Vzi varia tra 0V e 4V la corrente massima varia tra

size 16{ V_Zi = 0V ~ ~ drarrow ~ ~ I_Omax simeq 0A} newline
size 16{ V_Zi = 4V ~ ~ drarrow ~ ~ I_Omax simeq 20A}

in questo modo però la dinamica complessiva di corrente va da 0A a 20A ma visto che l’alimentatore è tarato per erogare massimo 5A solo un quarto della dinamica sarà utilizzata, quindi la tensione Vzi sarà ripartita tramite un partitore che la divide per quattro.

size 16 { I_Omax = {V_Zi over { G_d R_sh }} cdot { R_i2 over { R_i1 + R_i2 } } ~ ~ con ~ R_i2 = 22k %OMEGA ~ e ~ R_i1 = 56k %OMEGA} newline
size 16{ V_Zi = 4V ~ ~ drarrow ~ ~ I_Omax simeq 5,641A }

in questo modo la corrente varia tra 0A e 5,641A quindi la maggior parte della dinamica viene utilizzata.

Per concludere è stato inserito un raddrizzatore a doppia semi-onda che raddrizza il valore di corrente letto dal circuito di controllo, questo serve solo perché se il circuito di controllo viene connesso per sbaglio al contrario legge il valore di corrente con segno cambiato, quindi il valore in uscita all’amplificatore differenziale sarà negativo, e quindi l’alimentatore non funzionerà, per evitare questo fenomeno il segnale prima di arrivare al comparatore passa per il raddrizzatore che ne estrapola il modulo.

Per la taratura del transistor di passo bisogna imporre due condizioni, la corrente di collettore nominale deve essere maggiore della massima corrente che scorre nel circuito e la βf del transistore deve essere sufficiente ad amplificare la corrente dell’amplificatore operazionale che entra in base fino al valore della corrente che scorre sul carico.

Considerando la corrente di output dell’amplificatore di errore di poche decine di mA e sapendo che la corrente sul carico arriva fino a 5A trovo che il βf deve essere minimo

size 16{ %beta_f + 1= I_O over I_{max error amp} simeq {5A}over{0,01A} simeq 500 }

per ottenere questo valore di βf con correnti di collettore di 5A si è optato per una configurazione Darlington in cui il BJT di controllo è di media potenza con un βf più elevato, mentre il BJT pilotato è di potenza con un βf piu piccolo

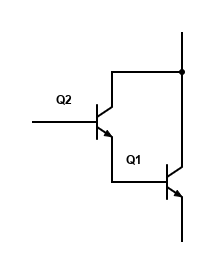
[picture p22: figure]

quando T1 è in zona attiva diretta la sua corrente di emettitore è pari a

size 16{ I_e1 = (%beta_f1 + 1)I_b1 }

questa corrente entra nella base di T2 e se anche T2 è in zona attiva diretta la sua corrente di emettitore sarà pari a

size 16{ I_e2 = (%beta_f2 +1)I_b2 = (%beta_f2 + 1)(%beta_f1 + 1)I_b1 }

quindi due transistor in questa configurazione si possono considerare come un unico transistor che ha emettitore e collettore di T2 ma pilotato dalla base di T1, infatti se lo consideriamo così, il βf equivalente sarà

size 16{ I_e = (%beta_f2 + 1)(%beta_f1 + 1)I_b = (%beta_f + 1)I_b} newline
size 16{ se ~ %beta_f2 >> 1 ~ e ~ %beta_f1 >> 1 ~ ~ drarrow ~ ~ %beta_f sim %beta_f1 cdot %beta_f2 }

i problemi di questa configurazione sono due principali

- La caduta tra base ed emettitore è la somma delle cadute base emettitore dei singoli transistor
- Il tempo per passare dalla saturazione alla zona attiva diretta detto tempo di dissaturazione è molto maggiore rispetto ad un singolo BJT

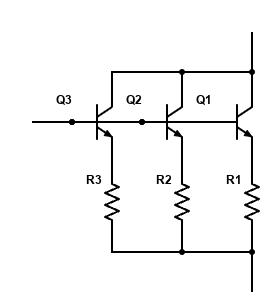
[picture p23: figure]

Per far gestire meglio al BJT il carico complessivo di corrente, il transistor di potenza verrà composto da due transistor di potenza in parallelo tra loro in modo da ripartirsi la corrente sul carico,il problema è che i BJT hanno alcuni parametri: come la VBEon o il βf molto dipendenti dalla temperatura, questo vuol dire che se li collegassi in parallelo rischierei di avere correnti di collettore diverse sui singoli BJT che potrebbero portare ad un fenomeno chiamato run down termico.

Nel caso di BJT in parallelo il run down termico diventa un fenomeno di cui tener conto se i vari βf dei transistor sono molto differenti tra loro, questo perché se c’è una grande disparità di βf tra i BJT, c’è anche una netta disparità di corrente tra i due BJT, quindi vuol dire che uno dei due si scalderà di più rispetto all’altro, per esempio

size 16{ se ~ %beta_f1 = 20 ~ e ~ %beta_f2 = 100 }newline
size 16{ a parità di V_be ~ ~ I_c1 over I_c2 = {%beta_f1 I_b1}over{%beta_f2 I_b2} simeq {%beta_f1}over{%beta_f2} = 0,2}

se un BJT scalda molto di più dell’altro, la corrente che scorrerà su di lui aumenterà poiché nei BJT il βf è proporzionale alla temperatura, quindi continuerà a scaldarsi e a condurre, fino a portare quasi tutto il carico di corrente.

Questo fenomeno rende quasi inutile l’utilizzo di questa configurazione, senza considerare il fatto che se io scelgo i due BJT per poter sopportare poco di più di metà della massima corrente del bipolo questo fenomeno mi porta ad un netto squilibrio della corrente sui BJT fino anche alla rottura dei singoli transistor,

quindi per ovviare a questo problema si può collegare in serie agli emettitori dei BJT una piccola resistenza del valore compreso tra 0.1Ω e 1Ω che equilibra le correnti che attraversano i vari elementi, anche se essi presentano piccole differenze strutturali.

Se il guadagno di ogni transistor non è simile la tensione ai capi della resistenza sull'emettitore si sottrae a quella che pilota la base del transistor determinando una retroazione negativa e questo ripartisce la corrente in eccesso sugli altri transistor.

Per il circuito di regolazione utilizzo l’integrato LM723 che contiene al suo interno un amplificatore operazionale che pilota un BJT di controllo la cui base è collegata ad un altro BJT per la regolazione della corrente.

L’integrato LM723 è fatto come in figura

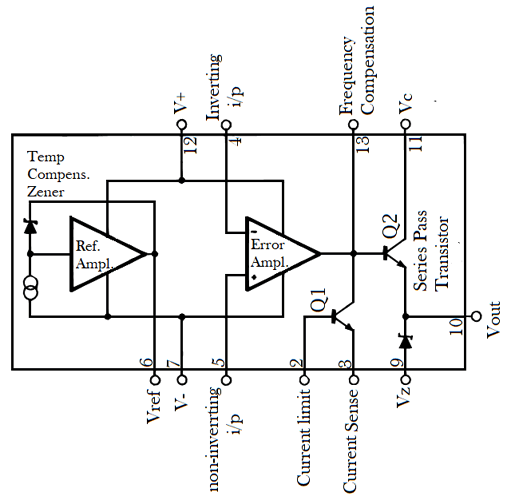
[picture p24: figure]

il reference amplifier è un buffer che prende come riferimento la tensione stabilizzata da uno zener interno compensato per le variazioni di temperatura, nel nostro caso la tensione di riferimento viene generata dal circuito di controllo, quindi non utilizzeremo questo pin.

Per gli altri circuiti con amplificatori operazionali sono stati utilizzati due TL082, degli amplificatori operazionali a j-fet con corrente di polarizzazione 50pA e slew rate 13 V/us.

Alimentazioni ausiliarie

Per l’alimentazione degli amplificatori operazionali è stato scelto di utilizzare una alimentazione duale +12V e -12V.

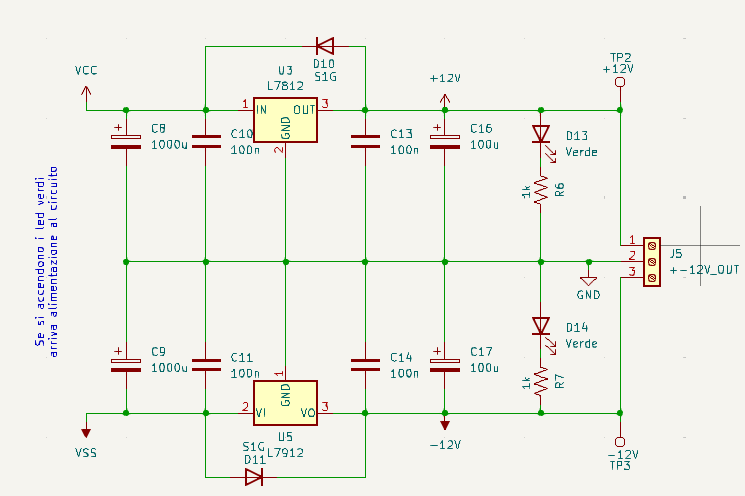
[picture p25: figure]

La +12V viene creata partendo dalla linea Vi a 25V in continua e abbassandola con un regolatore di tensione lineare, l’integrato LM7812.

La -12V viene invece creata partendo dal secondo avvolgimento del trasformatore che manda in uscita una tensione sinusoidale di valore efficace pari a 15V.

Raddrizzando e filtrando questo segnale si è in grado di ottenere una tensione a 15V in continua, dopodiché si collega la +15V alla massa del circuito in modo da ottenere una linea a -15V.

Per il dimensionamento del ponte di diodi e del condensatore di questa linea si usano le stesse formule per il dimensionamento utilizzate per la linea Vi a 25V, ma la corrente di assorbimento sarà molto minore poiché queste linee verranno utilizzate per l’alimentazione di tutti i componenti attivi del circuito che assorbono complessivamente molta meno corrente

rispetto alla massima erogabile sul carico.

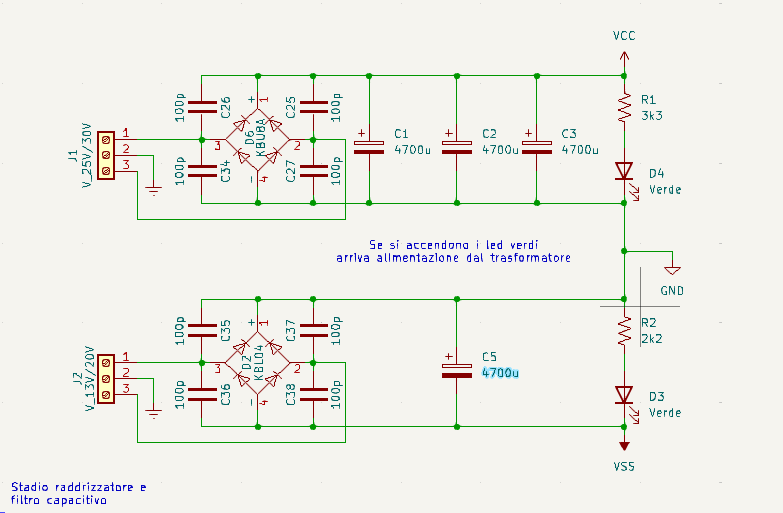
[picture p26: figure]

Il circuito complessivo del filtro capacitivo e raddrizzatore è il seguente.

Come si può notare la capacità di filtro complessiva della linea -15V è molto minore della capacità complessiva della linea Vi, inoltre anche il ponte di diodi è diverso, ed è tarato per delle correnti di picco molto minori. Ponte di diodi e condensatore devono rispettare quindi le seguenti caratteristiche.

size 16{ C sim T over V_rpp cdot I_M simeq
{ 0,02s } over { 2V } cdot 0,5A simeq
5000uF } newline
size 16 { T_C = T-t sim { { V_rpp over V_M - sqrt{ { V_rpp^2 } over { V_M^2 } + 8 cdot { V_rpp over V_M %pi^2 } } } } over { { 4 %pi } over T } simeq 4,956 ms } newline
size 16{ I_Dmax = I_M cdot { T over {2 T_C} } simeq { 1,01A } }

La linea di alimentazione a -15V viene poi stabilizzata a -12V dall’integrato LM7912.

Per concludere serve poi una linea a +5V ottenuta partendo dalla linea a +12V stabilizzata a +5V con l’integrato LM7805

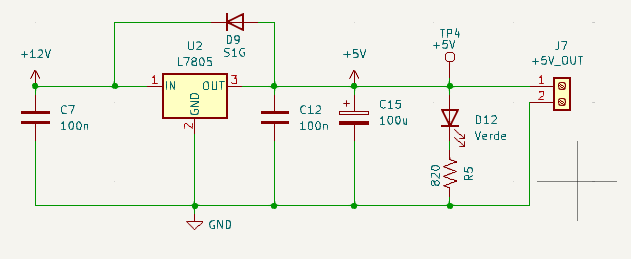
[picture p27: figure]

Adesso analizziamo le alimentazioni dei singoli circuiti

- LM723 deve poter mandare in uscita tensioni comprese tra 0V e 20V quindi viene alimentato tra Vi e -12V
- TL082 adibito all’estrapolazione del modulo della corrente letta dall’amplificatore differenziale e alla comparazione di questo valore con la tensione di riferimento per la limitazione della corrente, deve poter mandare in uscita tensioni comprese tra 0V e la tensione massima di lettura della corrente, può essere alimentato tra +12V e -12V
- TL082 adibito all’estrapolazione del modulo della tensione letta di tracking, deve poter mandare in uscita tensioni tra Vi e 0V quindi sarebbe comodo alimentarlo tra Vi e -12V, tuttavia la massima tensione differenziale di alimentazione applicabile al TL082 è 36V

size 16{ V_i - (-12V) simeq 37V > 36V }

quindi bisogna creare, partendo dalla -12V già presente su scheda una tensione negativa di valore assoluto più piccolo.

Per farlo si è montato un regolatore serie per tensioni negative, stabilizzato con uno zener a 3,4V in modo da avere una tensione di uscita stabilizzata compresa tra -4,7V e -3V.

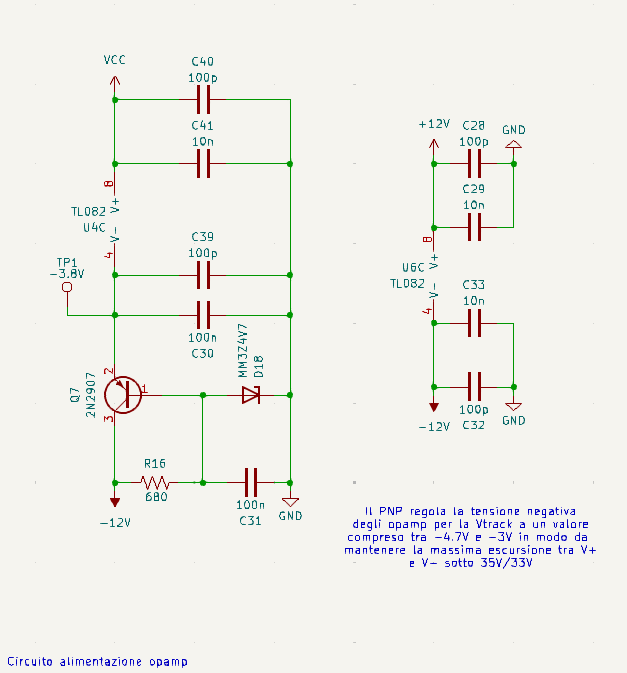
[picture p28: figure]

Taratura circuito di tracking

Quando il circuito entra in modalità tracking, la tensione di tracking passerà per un raddrizzatore a doppia semi-onda come in figura.

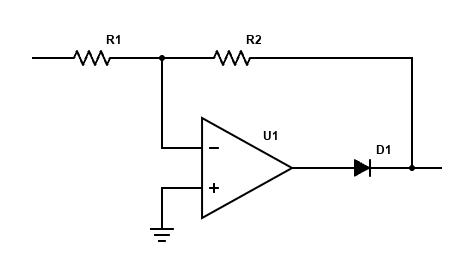
[picture p29: figure]

Il problema di questa configurazione quando il valore della tensione di tracking è negativa, il diodo è interdetto e la tensione in uscita è uguale a quella in ingresso, quando però la tensione di tracking è negativa il diodo è in conduzione e la tensione di uscita vale

size 16{ V_O = - V_tracking R_2 over R_1 }

e se R1 e R2 sono diverse tra loro per via delle tolleranze dei resistori commerciali, VO è diverso da Vtracking.

Consideriamo una tolleranza del 10% per i resistori

size 16{ V_O =
-V_tracking { { R_2 +- 0,1 cdot R_2 } over { R_1 +- 0,1 cdot R_1 } } =
-V_tracking { R_2 over R_1 } cdot { { 1 +- 0,1 } over { 1 +- 0,1 } } =
-V_tracking { R_2 over R_1 } cdot
( 1, overline {02} +- 0, overline {20} ) }

per compensare l’errore introdotto dalle tolleranze dei resistori si inserisce in serie ad esse una resistenza variabile

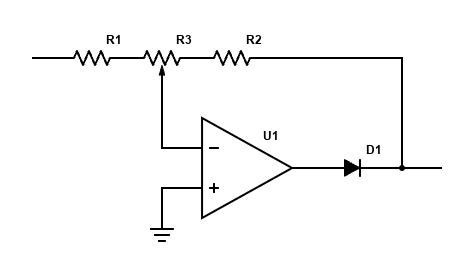
[picture p30: figure]

in questo modo la tensione in uscita diventa

size 16{ V_O = -V_tracking { {R_2 cdot (1 +- 0,1) + (R_tot - R_x) } over {R_1 cdot (1 +- 0,1) + R_x } } }

chiamiamo ε1 e ε2 le tolleranze dei resistori R1 e R2

size 16{ V_O = -V_tracking { { R_2 cdot (1 + %varepsilon_2 ) + (R_tot - R_x) } over { R_1 cdot (1 + %varepsilon_1) + R_x } } = -V_tracking R_2 over R_1 } newline
size 16{ R_x = R_tot cdot ( R_1 over {R_1 + R_2 }) + (R_2 /{}/{} R_1) cdot ( %varepsilon_2 - %varepsilon_1 ) } newline
size 16{ R_x %epsilon [R_tot cdot ( R_1 over {R_1 + R_2 }) -0,2 cdot (R_2 /{}/{} R_1);R_tot cdot ( R_1 over {R_1 + R_2 }) + 0,2(R_2 /{}/{} R_1)] }

quindi visto che Rx è compreso tra 0Ω e Rtot imponendo questi vincoli trovo il valore minimo di Rtot che permette la compensazione dell’errore.

size 16{ R_tot cdot (R_1 over { R_1 + R_2 }) - 0,2 (R_2 /{}/{} R_1) > 0 } newline
size 16{ R_tot cdot (R_1 over { R_1 + R_2 }) + 0,2 (R_2 /{}/{} R_1) < R_tot }

Visto che voglio VO pari a -Vtracking quando Vtracking è negativa, ho bisogno di R1 uguale a R2, quindi chiamo R1 = R2 = R

size 16{ R_tot over 2 - 0,2 cdot { R over 2} > 0 ~ ~ drarrow ~ ~ R_tot > 0,2R} newline
size 16{ R_tot over 2 + 0,2 cdot { R over 2} < R_tot ~ ~ drarrow ~ ~ R_tot > 0,2R}

Quindi scegliendo R=4,7kΩ (valore commerciale) otteniamo che

Rtot > 0,94kΩ quindi scegliamo il valore di 1kΩ per il trimmer di taratura.

Per la taratura del circuito di tracking bisogna mandare in ingresso ai pin di tracking una tensione negativa nota e ruotare il trimmer di regolazione finché in uscita non avrò la stessa tensione in ingresso con segno cambiato.

Per permettere questa cosa, nel circuito è stato inserito un deviatore di taratura che connette l’ingresso del raddrizzatore alla linea -12V del circuito in modo da poterla tarare.

Analisi del circuito di lettura di tensione e corrente

Il circuito di lettura di tensione e corrente è formato da un voltmetro e da un amperometro che condizionano il segnale letto convertendolo in una tensione leggibile da un ADC connesso ad un microcontrollore che mostrerà su un display la misura di corrente e tensione letta dallo strumento

Voltmetro con fondo scala variabile

Il voltmetro è formato da un amplificatore operazionale in configurazione non invertente che amplifica la tensione letta in ingresso in modo da renderla leggibile dall’ADC che trasmetterà l’informazione al microcontrollore.

Il vantaggio di utilizzare una configurazione non invertente è quello di avere una resistenza di ingresso molto elevata e quindi il problema del caricamento della sorgente è trascurabile, tuttavia c’è un grosso problema, infatti il guadagno di una configurazione non invertente è sempre maggiore di uno, quindi si possono adottare due tecniche differenti:

- Si inserisce un partitore resistivo a partizione variabile in ingresso all’amplificatore
- Si utilizza una configurazione invertente a guadagno variabile

l’idea è quella di modificare il fondo scala utilizzando degli switch analogici C-MOS controllati dal microcontrollore.

I fondo-scala che voglio avere sono 2V, 10V, 25V e 100V e le tensioni leggibili dall’ADC sono comprese tra 0V e 5V.

Voltmetro a partitore resistivo

Nel circuito con partitore resistivo il guadagno dello stadio non invertente deve essere tarato in funzione del minimo fondo-scala

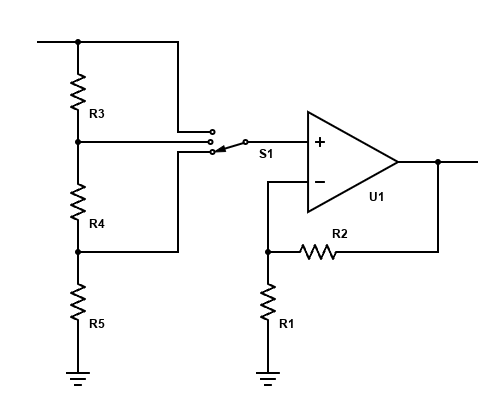
[picture p31: figure]

infatti sapendo che il minimo fondo-scala è 2V e che la tensione in uscita deve essere compresa tra 0V e 5V posso trovare il guadagno dello stadio non invertente come

size 16{ G = 1 + R_2 over R_1 =V_{max ADC} over V_{min fondoscala} simeq 2,5 }

trovato il guadagno dello stadio non invertente si possono calcolare i vari rapporti di partizione in base ai fondo-scala desiderati

size 16{ %alpha_10 = V_{max ADC} over { V_fondoscala10 cdot G } simeq 0,2 } newline
size 16{ %alpha_25 = V_{max ADC} over { V_fondoscala25 cdot G } simeq 0,08 } newline
size 16{ %alpha_100 = V_{max ADC} over { V_fondoscala100 cdot G } simeq 0,02 } newline

adesso sapendo i rapporti di partizione si trovano i coefficienti di proporzionalità dei singoli resistori partendo dal resistore R3

alignl size 16{ R_tot = R_3 + R_4 + R_5 + R_6 }newline

alignl size 16{ R_3 over R_tot = %alpha_10 }newline
alignl size 16{ { { R_3 + R_4 } over { alignc R_tot } } = %alpha_25 }newline
alignl size 16{ { { R_3 + R_4 + R_5 } over { alignc R_tot } } = %alpha_100 }newline

risolvendo il sistema con R3 come parametro libero otteniamo

alignl size 16{ R_6 = R_3 cdot (1 + { alignc { 1- %alpha_10 }} over {alignc %alpha_100 } ) simeq 41 cdot R_3 }newline
alignl size 16{ R_5 = R_3 cdot ( %alpha_10 over %alpha_100 - %alpha_25 over %alpha_100 ) simeq 6 cdot R_3 }newline
alignl size 16{ R_4 = R_3 cdot (%alpha_25 over %alpha_100 - 1) simeq 3 cdot R_3 }

la resistenza più grande di tutte è R6, che è 41 volte più grande di R3.

Voltmetro a guadagno variabile

Facciamo gli stessi calcoli per la configurazione non invertente a guadagno variabile

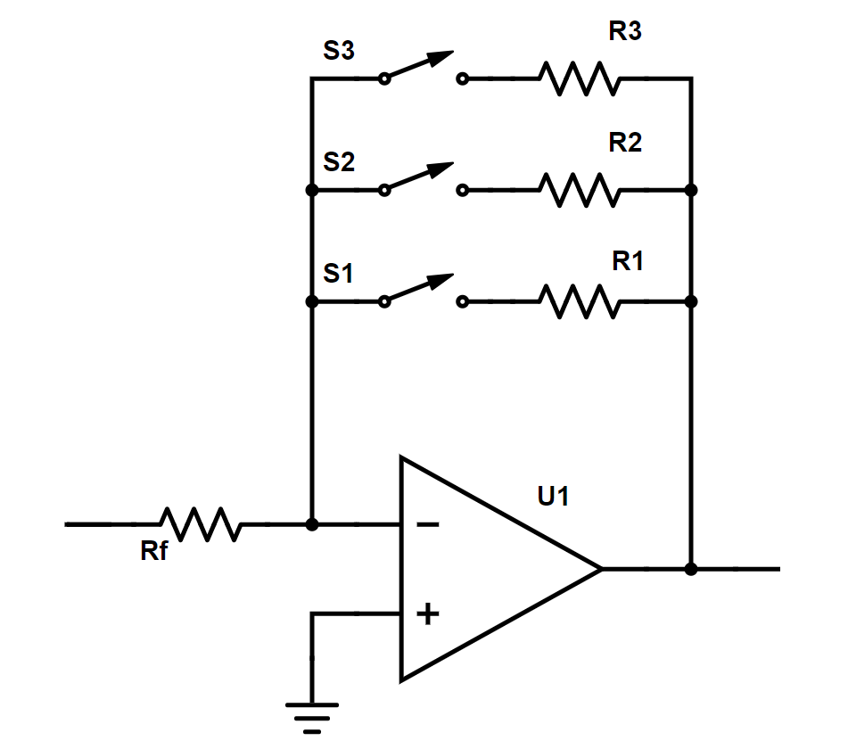
[picture p32: figure]

calcoliamo i guadagni associati ad ogni fondo-scala non curandoci del segno (se la tensione letta avrà segno opposto a quella reale si potrà impostare il microcontrollore in maniera tale che cambi il segno della tensione mostrata sul display).

size 16{ G_2 = R_1 over R_f = V_{max ADC} over V_fondoscala2 simeq 2,5 }newline
size 16{ G_10 = R_2 over R_f = V_{max ADC} over V_fondoscala10 simeq 0,5 }newline
size 16{ G_25 = R_3 over R_f = V_{max ADC} over V_fondoscala25 simeq 0,2 }newline
size 16{ G_100 = R_4 over R_f = V_{max ADC} over V_fondoscala100 simeq 0,05 }newline

il rapporto tra le resistenze sarà quindi

size 16{ R_1 simeq 2,5 cdot R_f } newline
size 16{ R_2 simeq 0,5 cdot R_f } newline
size 16{ R_3 simeq 0,2 cdot R_f } newline
size 16{ R_4 simeq 0,05 cdot R_f } newline

qui la resistenza più grande di tutte è R1 che è 2,5 volte più grande di Rf.

Confronto circuiti voltmetro

Nella prima configurazione la resistenza in ingresso al voltmetro non varia se trascuriamo la resistenza in ingresso all’operazionale, quindi

size 16{ R_{i{}n} simeq R_3+R_4+R_5+R_6 = R_tot }

Se consideriamo la resistenza in ingresso dell’amplificatore operazionale vale

alignl size 16{ prima posizione ~ ~ R_{i{}n opamp} /{}/{} ( R_3 + R_4 + R_5 + R_6 ) } newline
alignl size 16{ seconda posizione ~ ~ [ R_{i{}n opamp} /{}/{} ( R_3 + R_4 + R_5 ) ] + R_6 } newline
alignl size 16{ terza posizione ~ ~ [ R_{i{}n opamp} /{}/{} ( R_3 + R_4 ) ] + R_6 + R_5} newline
alignl size 16{ quarta posizione ~ ~ ( R_{i{}n opamp} /{}/{} R_3 ) + R_6 + R_4 + R_5} newline

Nella seconda configurazione invece se consideriamo il cortocircuito virtuale abbiamo che la resistenza d’ingresso vale

size 16{ R_{i{}n} = R_f }

quindi la resistenza di ingresso è maggiore nel caso del voltmetro a partitore resistivo.

La tensione di offset del primo voltmetro è amplificata per un termine costante pari a

size 16{ V_O = V_io cdot G simeq 2,5 cdot V_io }

mentre nel secondo voltmetro la tensione di offset è moltiplicata per un fattore diverso ogni volta che cambio fondo-scala

alignl size 16{ prima posizione ~ ~ V_O = V_io cdot (1 + R_1 over R_f) simeq 3,5 cdot V_io} newline
alignl size 16{ seconda posizione ~ ~ V_O = V_io cdot (1 + R_2 over R_f) simeq 1,5 cdot V_io} newline
alignl size 16{ terza posizione ~ ~ V_O = V_io cdot (1 + R_3 over R_f) simeq 1,2 cdot V_io} newline
alignl size 16{ quarta posizione ~ ~ V_O = V_io cdot (1 + R_4 over R_f) simeq 1,05 cdot V_io} newline

in entrambi i circuiti ho che Vio viene moltiplicato per un fattore maggiore di uno, tuttavia nel secondo circuito ho una situazione migliore sempre tranne quando siamo nella prima posizione, che sfortunatamente è anche quella con fondo-scala minore.

Le correnti di polarizzazione nel primo circuito sono moltiplicate per il valore delle resistenze in parallelo al partitore e per il valore della resistenza di feedback

alignl size 16{ prima posizione ~ ~ V_O = I^{+{}} cdot (R_3 + R_4 + R_5 + R_6) - I^{-{}} cdot R_2 } newline
alignl size 16{ seconda posizione ~ ~ V_O = I^{+{}} cdot R_3 /{}/{} ( R_4 + R_5 + R_6) - I^{-{}} cdot R_2} newline
alignl size 16{ terza posizione ~ ~ V_O = I^{+{}} cdot (R_3 + R_4)/{}/{} (R_5 + R_6) - I^{-{}} cdot R_2} newline
alignl size 16{ quarta posizione ~ ~ V_O = I^{+{}} cdot (R_3 + R_4 + R_5 )/{}/{} R_6 - I^{-{}} cdot R_2} newline

nel secondo circuito influisce soltanto la resistenza di feedback

alignl size 16{ prima posizione ~ ~ V_O = - I^{-{}} cdot R_1 } newline
alignl size 16{ seconda posizione ~ ~ V_O = - I^{-{}} cdot R_2} newline
alignl size 16{ terza posizione ~ ~ V_O = - I^{-{}} cdot R_3} newline
alignl size 16{ quarta posizione ~ ~ V_O = - I^{-{}} cdot R_4} newline

e non ho alcun contributo dovuto alla corrente di polarizzazione del pin non invertente dell’amplificatore operazionale.

Amperometro con fondo scala variabile

Il circuito per la lettura della corrente, converte la corrente in ingresso in una tensione leggibile dall’ADC connesso al microcontrollore, quest’ultimo mostrerà poi a schermo il valore di corrente letto.

La conversione della corrente in tensione avviene facendola passare attraverso una resistenza di valore noto e misurando la caduta di tensione ai suoi capi, in questo modo sapendo il valore di resistenza si può ricavare la corrente letta con la legge di ohm

size 16{ I = V_R over R }

Amperometro con convertitore corrente tensione

Il convertitore corrente tensione è un circuito costituito da un amplificatore operazionale e una resistenza di retroazione negativa.

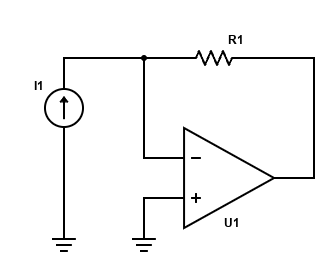
[picture p33: figure]

Il funzionamento di questo circuito si basa sul fatto che la corrente in ingresso all’operazionale è molto piccola, pressoché nulla, quindi la tensione in uscita all’operazionale si può calcolare col metodo del corto circuito virtuale.

size 16{ V_o = - R_1 cdot I_1 }

Si può verificare la validità del metodo considerando il circuito equivalente dell’amplificatore operazionale.

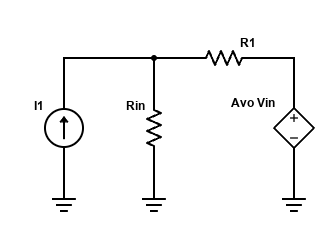
[picture p34: figure]

size 16{ V_o = A_Vo (V^{+{}} - V^{-{}}) =
- A_Vo I_1 { R_{i{}n{}} cdot R_1 } over { R_{i{}n{}}( 1 + A_Vo ) + R_1 } }

facendo tendere Avo all’infinito si ottiene la formula di sopra

size 16{ lim from{ A_Vo rightarrow infinity } V_o =
- I_1 cdot { { R_{i{}n{}} cdot R_1 }over R_{i{}n{}} } = -R_1 cdot I_1 }

Amperometro con resistore di shunt

Questo circuito è formato da un amplificatore differenziale che legge la tensione ai capi della resistenza Rsh

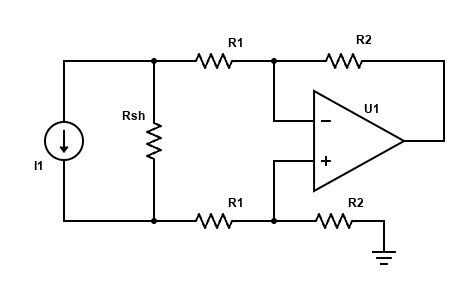
[picture p35: figure]

per far sì che la lettura della tensione su Rsh non sia alterata dalla resistenza interna dell’amplificatore differenziale, Rsh deve essere molto più piccola di quest’ultima.

Calcoliamo quindi la resistenza in ingresso dell’amplificatore differenziale

collegando un generatore di prova e calcolando la corrente assorbita.

Colleghiamo prima un generatore di prova VP1 all’ingresso invertente dell’amplificatore differenziale, usando il cortocircuito virtuale si trova che la resistenza in ingresso è

size 16{ I_P1 = V_P1 over R_1 drarrow R_{i{}n{}1} = V_P1 over I_P1 = R_1 }

colleghiamo adesso un generatore di prova VP2 all’ingresso non invertente e facciamo la stessa cosa

size 16{ I_P2 = V_P2 over { R_1 + R_2 } drarrow R_{i{}n{}2} = V_P2 over I_P2 = R_1 + R_2}

sapendo le resistenze viste in ingresso dai due punti, si possono sommare per ottenere la resistenza in ingresso differenziale tra gli ingressi del circuito.

size 16{ R_{i{}n{}d} = R_{i{}n{}1} + R_{i{}n{}2} = 2R_1 + R_2}

Sapendo la resistenza in ingresso del circuito possiamo dire che se non vogliamo alterare la lettura la resistenza di shunt deve essere molto minore della resistenza di ingresso del circuito, quindi

size 16{ R_sh << R_{i{}n{}d} }

Scelta circuiti di misura

Per il circuito di misura sono stati scelti il voltmetro a guadagno variabile e l’amperometro con resistenza di shunt e la tensione massima leggibile dall’ADC interno del microcontrollore è di 5V.

Per i due strumenti abbiamo scelto 4 fondo-scala distinti regolabili tramite l’integrato 74HC4066, che è formato da quattro switch C-MOS analogici a 5V, come in figura.

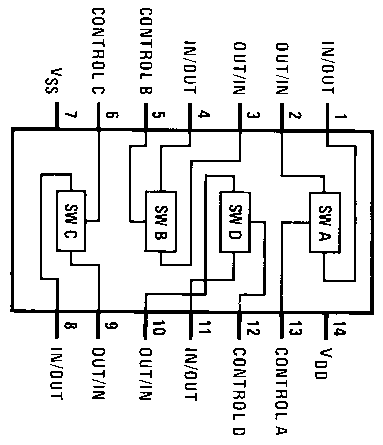
[picture p36: figure]

Dimensionamento voltmetro

Per il dimensionamento del circuito del voltmetro, scegliamo i quattro fondo-scala: 2V, 10V, 25V, 100V e calcoliamo i guadagni del circuito per ogni fondo-scala.

size 16{ %alpha_2 = V_{ADC} over V_{i{}n{}} = {5V} over {2V} simeq 2,5 } newline
size 16{ %alpha_10 = V_{ADC} over V_{i{}n{}} = {5V} over {10V} simeq 0,5 } newline
size 16{ %alpha_25 = V_{ADC} over V_{i{}n{}} = {5V} over {25V} simeq 0,2 } newline
size 16{ %alpha_100 = V_{ADC} over V_{i{}n{}} = {5V} over {100V} simeq 0,05 } newline

scelgo i valori di resistenze in modo che il guadagno della configurazione

sia quello calcolato per ogni fondoscala

size 16 { R_2 over R = %alpha_2 , R_10 over R = %alpha_10 , R_25 over R = %alpha_25 , R_100 over R = %alpha_100 }

scelgo un valore di R pari a 47kΩ e calcolo gli altri valori di resistenze di conseguenza

size 16{ R_2= %alpha_2 R simeq 117,5k %OMEGA ~ ~ R_2 sim 122k %OMEGA }newline
size 16{ R_10= %alpha_10 R simeq 23,5k %OMEGA ~ ~ R_10 sim 22k %OMEGA }newline
size 16{ R_25= %alpha_25 R simeq 9,4k %OMEGA ~ ~ R_25 sim 10k %OMEGA }newline
size 16{ R_100= %alpha_100 R simeq 2,35k %OMEGA ~ ~ R_100 sim 2,2k %OMEGA }

una volta tarate le resistenze bisogna assicurarsi che se misuro una tensione fuori scala la tensione in ingresso all’ADC non superi il massimo sopportabile, quindi si inseriscono due diodi zener in antiserie all’uscita del voltmetro per evitare che la tensione salga sopra quel valore, inoltre per limitare la corrente sugli zener bisogna inserire un resistore in serie all’uscita dell’amplificatore.

Scegliamo degli zener MM3Z4V7 con una tensione di zener di 4,7V una caduta di tensione in diretta di 0,6V una corrente di zener minima di 1mA e una corrente di zener massima di 60mA

size 16{ R_Z < { V_Omax - (V_Z + V_{%gamma}) } over { I_Zmin } simeq {12V - ( 4,7V + 0,6V )} over { 1 m A } simeq 6,7 k %OMEGA }newline
size 16{ R_Z > { V_Omax - (V_Z + V_{%gamma}) } over { I_Zmax } simeq {12V - ( 4,7V + 0,6V )} over { 60 mA } simeq 111,67 %OMEGA}

scelgo un valore intermedio di 1kΩ per RZ

Dimensionamento amperometro

Per il dimensionamento del circuito amperometro, scegliamo i quattro fondo-scala: 200mA, 1A, 2,5A, 8A.

Il fondoscala dell’amperometro verrà variato grazie ad un amplificatore a guadagno variabile posto a valle dell’amplificatore differenziale che legge la tensione ai capi del resistore di shunt.

Per prima cosa calcoliamo il fattore di proporzionalità tra la corrente letta e la tensione misurata affinché la lettura sia corretta, considerando lo stesso ADC che legge tensioni fino a 5V.

size 16{ R_{0,2} = V_{ADC} over I_{i{}n} = {5V} over {0,2A} simeq 25 %OMEGA }newline
size 16{ R_{1} = V_{ADC} over I_{i{}n} = {5V} over {1A} simeq 5 %OMEGA }newline
size 16{ R_{2,5} = V_{ADC} over I_{i{}n} = {5V} over {2,5A} simeq 2 %OMEGA }newline
size 16{ R_{8} = V_{ADC} over I_{i{}n} = {5V} over {8A} simeq 0,625 %OMEGA }

Il fattore di proporzionalità del circuito è una resistenza visto che lega una corrente ad una tensione.

Separando il circuito in due parti distinguo la parte in cui ho la resistenza di shunt e l’amplificatore differenziale e la parte in cui aggiusto il fondo-scala con un amplificatore a guadagno variabile.

Scegliendo un amplificatore differenziale con guadagno differenziale Gd unitario (per semplicità) e una resistenza di shunt di valore piccolo,

Rsh = 0,2Ω posso calcolare i guadagni dell’amplificatore di fondo-scala.

Per l’amplificatore differenziale a guadagno unitario scelgo tutte resistenze uguali che rispettino la condizione

size 16{ 2 R_1 + R_2 >> R_sh drarrow R >> R_sh over 3 simeq 0,067 }

scegliendo R = 10kΩ influisco in maniera trascurabile sulla lettura della tensione ai capi di Rsh.

Dimensionato il primo stadio posso analizzare l’amplificatore a guadagno variabile in modo che aggiusti il fondo-scala amplificando in maniera opportuna il segnale letto

size 16{ %alpha_{ 0,2 } = { V_{ADC} } over { R_sh G_d I_{i{}n} } = { 5V } over { 0,2 %OMEGA cdot 0,2A } simeq 125 }newline
size 16{ %alpha_{ 1 } = { V_{ADC} } over { R_sh G_d I_{i{}n} } = { 5V } over { 0,2 %OMEGA cdot 1A } simeq 25 }newline
size 16{ %alpha_{ 2,5 } = { V_{ADC} } over { R_sh G_d I_{i{}n} } = { 5V } over { 0,2 %OMEGA cdot 2,5A } simeq 10 }newline
size 16{ %alpha_{ 8 } = { V_{ADC} } over { R_sh G_d I_{i{}n} } = { 5V } over { 0,2 %OMEGA cdot 8A } simeq 3,125 }newline

avendo calcolato i vari guadagni associati ai fondo-scala posso ricavare i valori delle resistenze della configurazione, a differenza di prima, qui ho tutti guadagni maggiori di 1 quindi posso utilizzare una configurazione non invertente.

size 16 { ( 1 + R_0,2 over R ) = %alpha_0,2 , ( 1 + R_1 over R ) = %alpha_1 , ( 1 + R_2,5 over R ) = %alpha_2,5 , ( 1 + R_8 over R ) = %alpha_8 }

Scelgo un valore di R pari a 1kΩ e mi calcolo gli altri valori di conseguenza

size 16{ R_0,2 = ( %alpha_0,2 - 1 ) cdot R simeq 124k %OMEGA ~ ~ R_0,2 sim 122 k %OMEGA }newline
size 16{ R_1 = ( %alpha_1 - 1 ) cdot R simeq 24k %OMEGA ~ ~ R_0,2 sim 25 k %OMEGA }newline
size 16{ R_2,5 = ( %alpha_2,5 - 1 ) cdot R simeq 9k %OMEGA ~ ~ R_0,2 sim 10 k %OMEGA }newline
size 16{ R_8 = ( %alpha_8 - 1 ) cdot R simeq 2,125k %OMEGA ~ ~ R_0,2 sim 2,2 k %OMEGA }

Taratura circuito voltmetro

Il circuito del voltmetro ha due non idealità essenziali, da compensare:

- La tensione di offset
- La tolleranza dei resistori

Analizziamo la tensione di offset.

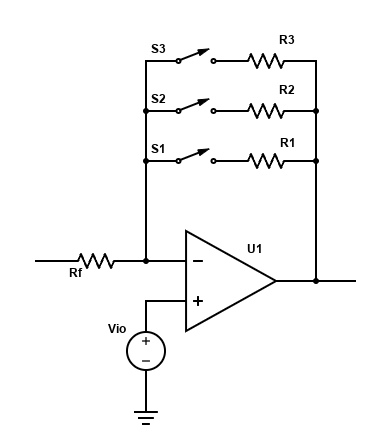
[picture p37: figure]

La tensione di offset nel circuito del voltmetro è applicata al pin non invertente, quindi viene amplificata per il guadagno dell’amplificatore in configurazione non invertente, quindi

size 16{ V_o = V_io cdot (1 + R_i over R_f) = V_io cdot (1 + %alpha_i) }

dove Ri variano in base al fondo-scala scelto e alla tolleranza dei resistori.

Si può procedere quindi in due modi:

- Si salva in una tabella all’interno del microcontrollore che contiene i valori della tensione di offset relativa ad ogni fondo-scala e si sottrae alla misura di tensione letta
- Si inserisce sul pin non invertente dell’amplificatore un generatore di tensione di modulo uguale a Vio e di segno opposto

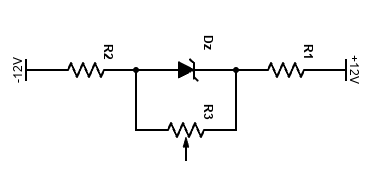
[picture p38: figure]

Per generare una tensione variabile in modulo e che possa essere regolata positivamente o negativamente si utilizza un circuito stabilizzatore a zener

Si scelgono R1 e R2 tali che la corrente sullo zener sia quella di lavoro

e si sceglie R3 in modo che sia molto maggiore di R1 e di R2, in questo modo

size 16{ I_Dz sim { V^{+{}} - V^{-{}} - V_Dz } over { R_1 + R_2 } } newline
size 16{ V_R2 sim V^{+{}} - V^{-{}} - V_Dz - R_1 I_Dz } newline
size 16{ V_R1 sim V^{+{}} - V^{-{}} - V_Dz - R_2 I_Dz }

se scelgo R1 = R2 ottengo che

size 16 { V_R2 = V^{+{}} - V^{-{}} - V_Dz - V_R1 ~ ~ drarrow ~ ~
V_R2 = V_R1 = { V^{+{}} - V^{-{}} - V_Dz } over 2 }

quindi regolando il trimmer R3 regolo la tensione in uscita

size 16{ V_o = { R_3L over R_3 } V_Dz + V_R2 + V^{-{}} sim
{ R_3L over R_3 } V_Dz + { V^{+{}} - V^{-{}} - V_Dz } over 2 + V^{-{}} =
{ V^{+{}} + V^{-{}} } over 2 + V_Dz ( R_3L over R_3 - 1 over 2 ) }

se V⁺ = -V⁻ ho che la tensione in uscita sarà

size 16{ V_o = V_Dz ( R_3L over R_3 - 1 over 2 ) }newline
size 16{ -V_Dz over 2 <= V_o <= V_Dz over 2 }

quindi sapendo che la Vio per gli amplificatori operazionali scelti (TL082) è sempre in modulo minore di 15mV devo scegliere uno zener da almeno 30mV (visto che per tensioni così basse va bene anche un diodo in conduzione si è scelto uno zener da 3,4V )

Per risolvere il problema dovuto alla tolleranza dei resistori si collega in serie ad ogni resistore un trimmer di compensazione che finirà in serie alle singole resistenze.

Per la taratura della tensione di offset bisogna cortocircuitare i terminali del voltmetro e inserendo il fondo-scala più piccolo (è quello che legge meglio le tensioni di piccolo valore) si va a leggere la tensione in uscita al circuito, dopodichè si ruota il trimmer fino a che la tensione letta non è nulla.

Per la taratura della tolleranza dei resistori si inserisce in ingresso al voltmetro un generatore di tensione di valore fisso noto.

Si regola il generatore in modo da generare la massima tensione leggibile col fondo-scala desiderato, dopodichè si regola il trimmer relativo a quel fondo-scala fino a che la tensione letta in uscita non è pari a 5V.

OSSERVAZIONE

Il processo di taratura della tensione di offset non è necessaria, quindi si può cortocircuitare il pin non invertente a massa e fare una taratura software se necessario

Taratura circuito amperometro

Per il circuito dell’amperometro ho gli stessi parametri parassiti del circuito del voltmetro, tuttavia per la taratura dell’offset non serve utilizzare un circuito come quello in precedenza, infatti viste le piccole tensioni che deve misurare l’amplificatore differenziale,

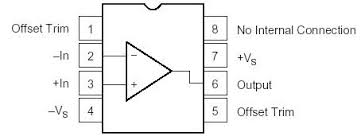
[picture p39: figure]

abbiamo utilizzato un amplificatore a basso offset (OPA627) con due pin per il collegamento di un trimmer di regolazione dell’offset esterno.

La procedura di taratura del circuito dell’amperometro è la stessa per il circuito del voltmetro, con la differenza che invece di inserire in ingresso un generatore di tensione per la taratura, andrà fatta scorrere una corrente di intensità nota attraverso il resistore di shunt dell’amperometro.
