dario0603/power_supply/Relazione/Immagini/CD4066 pinout.png

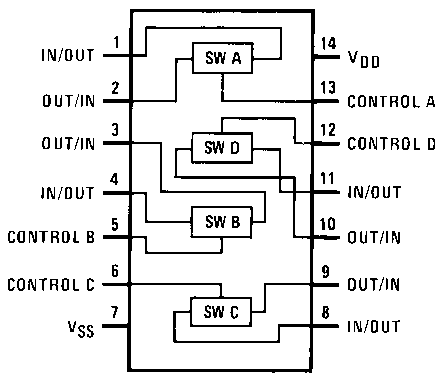
Relazione/Immagini/CD4066 pinout.png
