dario0603/power_supply/Relazione/Immagini/circuito per le variazioni amp di errore.png

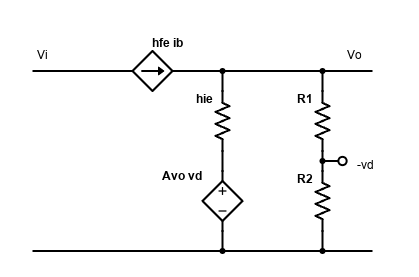
Relazione/Immagini/circuito per le variazioni amp di errore.png
