dario0603/power_supply/Relazione/Immagini/Circuito regolatore di tensione.PNG

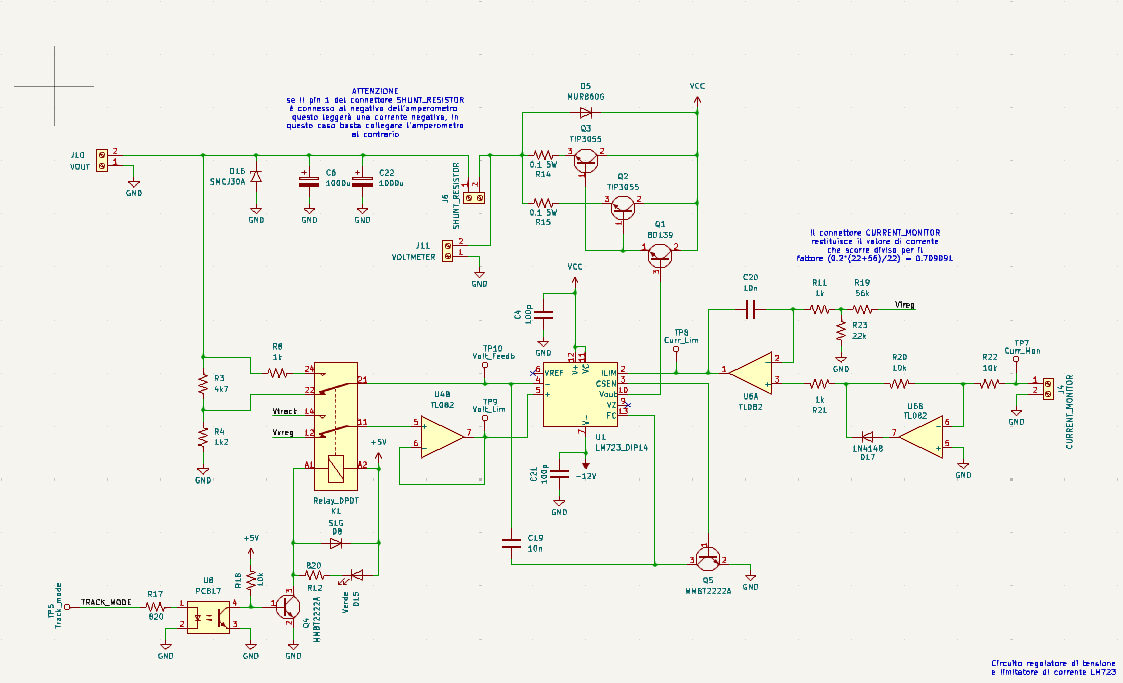
Relazione/Immagini/Circuito regolatore di tensione.PNG
