dario0603/power_supply/Relazione/Immagini/Circuito taratura kicad.PNG

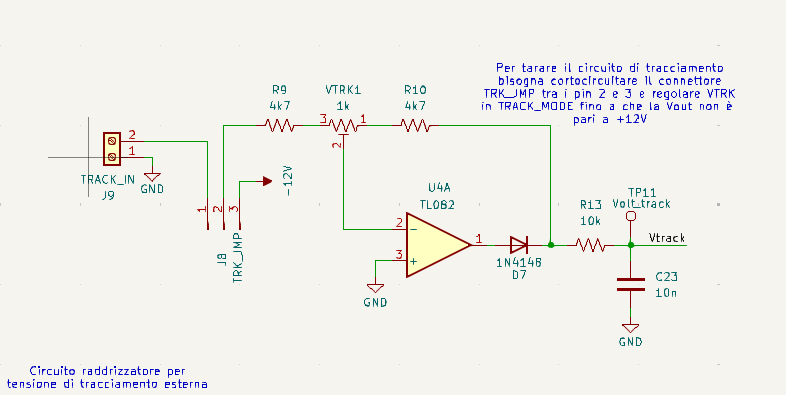
Relazione/Immagini/Circuito taratura kicad.PNG
