dario0603/power_supply/Relazione/Immagini/filtro capacitivo grafico.png

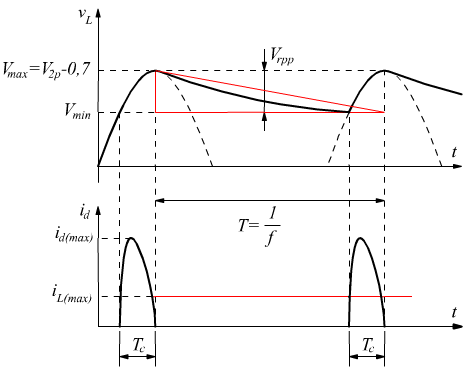
Relazione/Immagini/filtro capacitivo grafico.png
