dario0603/power_supply/Relazione/Immagini/Grafico singola semionda.jpg

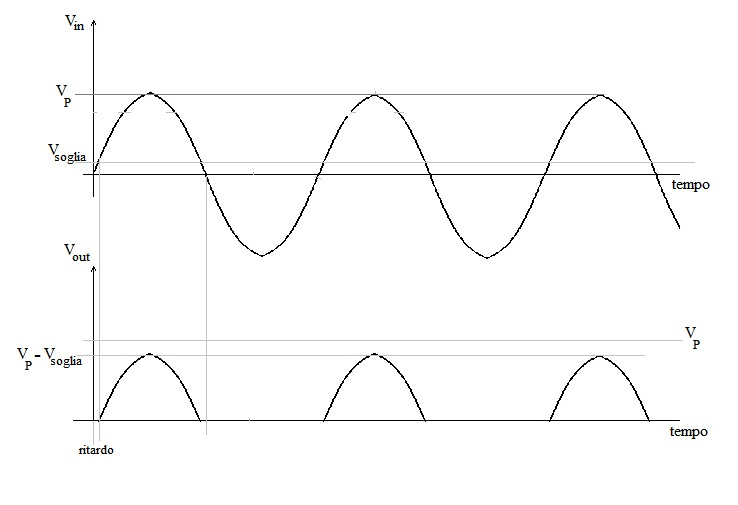
Relazione/Immagini/Grafico singola semionda.jpg
