dario0603/power_supply/Relazione/Immagini/LM723.png

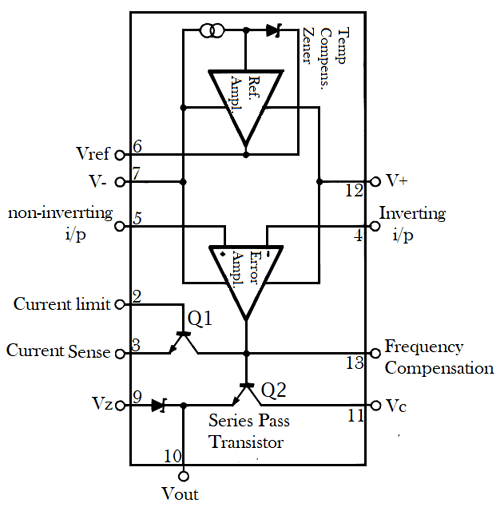
Relazione/Immagini/LM723.png
