dario0603/power_supply/Relazione/Immagini/Raddrizzatore singola semionda.jpg

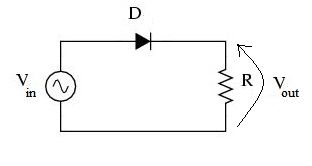
Relazione/Immagini/Raddrizzatore singola semionda.jpg
