dario0603/power_supply/Relazione/Immagini/Simulazione filtro e raddrizzatore carico costante.PNG

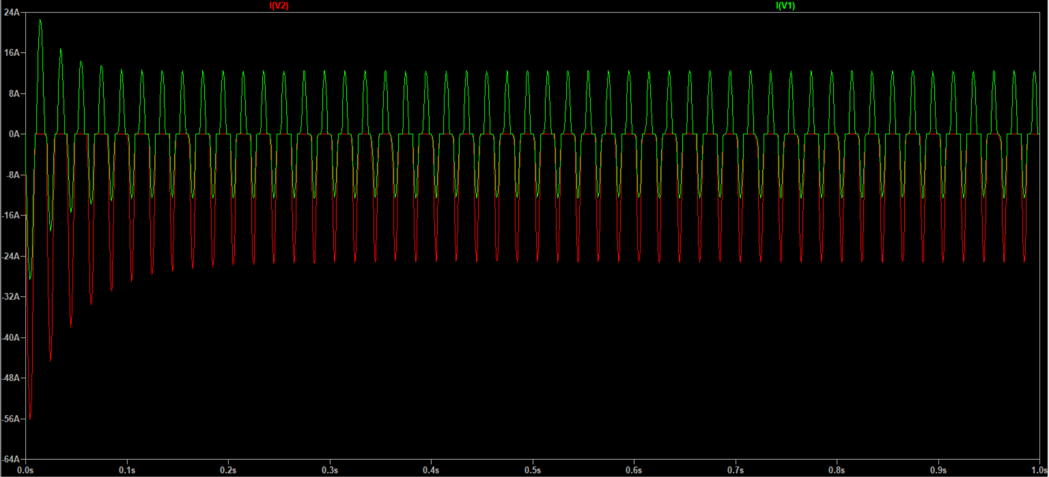
Relazione/Immagini/Simulazione filtro e raddrizzatore carico costante.PNG
