dario0603/power_supply/Relazione/Immagini/Simulazione filtro e raddrizzatore.PNG

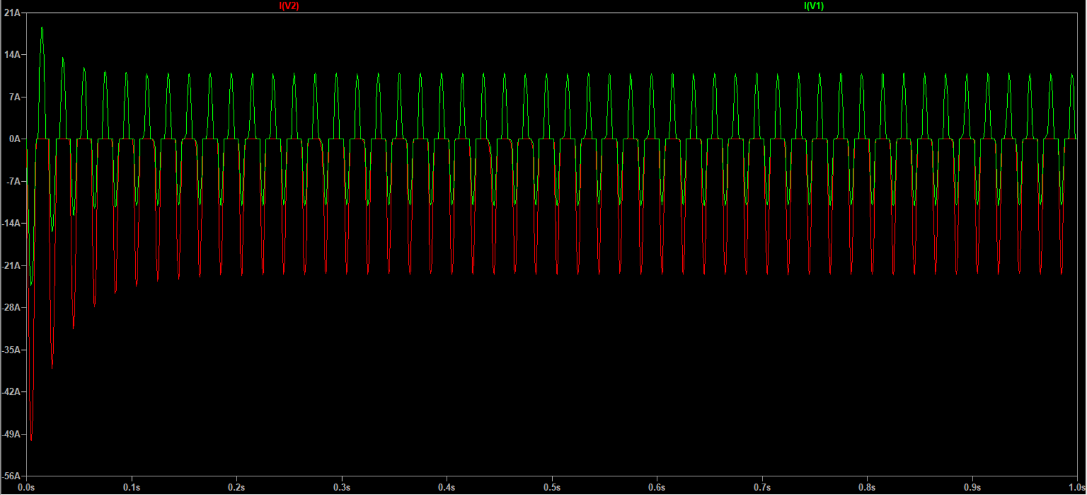
Relazione/Immagini/Simulazione filtro e raddrizzatore.PNG
