dario0603/power_supply/Controllore taratura manuale/Kicad/Progetto Costruzioni/Progetto Costruzioni BOM.ods

Source: | C:\Users\Dario\Desktop\Projects\Alimentatore\Controllore\Kicad\Progetto Costruzioni\Progetto Costruzioni.kicad_sch
Date: | 2024-04-15T11:41:20+0200
Tool: | Eeschema 8.0.1
Generator: | C:\Program Files\KiCad\8.0\bin\scripting\plugins/bom_csv_grouped_by_value_with_fp.py
Component Count: | 144
Ref | Qnty | Value | Cmp name | Footprint | Description | Vendor | DNP
C1, C4, C7, C8, C9 | 5 | 10n | C | Capacitor_SMD:C_0805_2012Metric_Pad1.18x1.45mm_HandSolder | Unpolarized capacitor
C2, C3, C6, C15, C16, C19, C20, C24, C25 | 9 | 100p | C | Capacitor_SMD:C_0805_2012Metric_Pad1.18x1.45mm_HandSolder | Unpolarized capacitor
C5, C13, C14, C17, C18, C30, C31 | 7 | 100n | C | Capacitor_SMD:C_0805_2012Metric_Pad1.18x1.45mm_HandSolder | Unpolarized capacitor
C26, C28 | 2 | 22p | C | Capacitor_SMD:C_0805_2012Metric_Pad1.18x1.45mm_HandSolder | Unpolarized capacitor
D2, D9 | 2 | BAT54W | BAT54W | Package_TO_SOT_SMD:SOT-23 | Schottky barrier diode, SOT-323
D3, D10, D11, D12 | 4 | MM3Z4V7 | MM3Zxx | Diode_SMD:D_SOD-323 | 300mW Zener Diode, SOD-323F
D5, D6, D7, D8 | 4 | 1N4148 | 1N4148 | Diode_SMD:D_SOD-323F | 100V 0.15A standard switching diode, DO-35
D13, D14, D23 | 3 | S1G | 1N4148 | Diode_SMD:D_SMA_Handsoldering | 100V 0.15A standard switching diode, DO-35
D15 | 1 | 1N6300CA | 1N630xCA | Diode_THT:D_DO-201AE_P15.24mm_Horizontal | 1500W bidirectional TRANSZORB® Transient Voltage Suppressor, DO-201AE
D24, D26, D28 | 3 | Verde | LED | LED_SMD:LED_0805_2012Metric_Pad1.15x1.40mm_HandSolder | Light emitting diode
DS1 | 1 | WC1602A | WC1602A | Display:WC1602A | LCD 16x2 Alphanumeric , 8 bit parallel bus, 5V VDD
F1 | 1 | 11A | Fuse |  | Fuse
J1 | 1 | connettore voltmetro | Screw_Terminal_01x02 |  | Generic screw terminal, single row, 01x02, script generated (kicad-library-utils/schlib/autogen/connector/)
J2 | 1 | connettore amperometro | Screw_Terminal_01x02 |  | Generic screw terminal, single row, 01x02, script generated (kicad-library-utils/schlib/autogen/connector/)
J3 | 1 | Connettore 12V | Screw_Terminal_01x03 |  | Generic screw terminal, single row, 01x03, script generated (kicad-library-utils/schlib/autogen/connector/)
J4 | 1 | Connettore ISP | Conn_02x03_Top_Bottom | Connector_PinHeader_2.54mm:PinHeader_2x03_P2.54mm_Vertical | Generic connector, double row, 02x03, top/bottom pin numbering scheme (row 1: 1...pins_per_row, row2: pins_per_row+1 ... num_pins), script generated (kicad-library-utils/schlib/autogen/connector/)
J5 | 1 | connettore 5V | Screw_Terminal_01x02 |  | Generic screw terminal, single row, 01x02, script generated (kicad-library-utils/schlib/autogen/connector/)
J6 | 1 | Current monitor | Screw_Terminal_01x02 |  | Generic screw terminal, single row, 01x02, script generated (kicad-library-utils/schlib/autogen/connector/)
J7 | 1 | Connettore alimentatore | Conn_01x04_Pin | Connector_PinHeader_2.54mm:PinHeader_1x04_P2.54mm_Vertical | Generic connector, single row, 01x04, script generated
K1, K2 | 2 | Relay 3A | Relay_DPDT | Relay_THT:Relay_DPDT_Finder_30.22 | Monostable Relay DPDT, EN50005
K3 | 1 | Relay 10A | Relay_DPDT |  | Monostable Relay DPDT, EN50005
Q1, Q2, Q4 | 3 | MMBT2222A | BC817 | Package_TO_SOT_SMD:SOT-23 | 0.8A Ic, 45V Vce, NPN Transistor, SOT-23
R1, R30, R31, R50, R51, R52, R56, R57, R58, R59 | 10 | 47k | R_US | Resistor_SMD:R_0805_2012Metric_Pad1.20x1.40mm_HandSolder | Resistor, US symbol
R2, R34 | 2 | 100k | R_US | Resistor_SMD:R_0805_2012Metric_Pad1.20x1.40mm_HandSolder | Resistor, US symbol
R3, R38, R41 | 3 | 22k | R_US | Resistor_SMD:R_0805_2012Metric_Pad1.20x1.40mm_HandSolder | Resistor, US symbol
R4, R7, R8, R9, R10, R11, R12, R13, R14, R15, R16, R17, R23, R24, R25, R26, R27, R28, R29, R36, R39, R42, R43, R44, R45, R46, R47, R48, R49, R54 | 30 | 10k | R_US | Resistor_SMD:R_0805_2012Metric_Pad1.20x1.40mm_HandSolder | Resistor, US symbol
R5 | 1 | 2k2 | R_US | Resistor_SMD:R_0805_2012Metric_Pad1.20x1.40mm_HandSolder | Resistor, US symbol
R6, R33, R37 | 3 | 1k | R_US | Resistor_SMD:R_0805_2012Metric_Pad1.20x1.40mm_HandSolder | Resistor, US symbol
R18, R19, R20, R21, R22 | 5 | 1.0 5W | R_US | Resistor_THT:R_Box_L8.4mm_W2.5mm_P5.08mm | Resistor, US symbol
R32 | 1 | 4k7 | R_US | Resistor_SMD:R_0805_2012Metric_Pad1.20x1.40mm_HandSolder | Resistor, US symbol
R35 | 1 | 15k | R_US | Resistor_SMD:R_0805_2012Metric_Pad1.20x1.40mm_HandSolder | Resistor, US symbol
R40, R53 | 2 | 1k5 | R_US | Resistor_SMD:R_0805_2012Metric_Pad1.20x1.40mm_HandSolder | Resistor, US symbol
R55 | 1 | 220 | R_US | Resistor_SMD:R_0805_2012Metric_Pad1.20x1.40mm_HandSolder | Resistor, US symbol
RV1 | 1 | 15k | R_Potentiometer_Trim_US |  | Trim-potentiometer, US symbol
RV2 | 1 | 1k | R_Potentiometer_Trim_US |  | Trim-potentiometer, US symbol
SW1 | 1 | SW_Push_Dual | SW_Push_Dual |  | Push button switch, generic, symbol, four pins
SW2 | 1 | RotaryEncoder_Switch | RotaryEncoder_Switch |  | Rotary encoder, dual channel, incremental quadrate outputs, with switch
TP1 | 1 | Iout | TestPoint | TestPoint:TestPoint_Pad_D1.0mm | test point
TP2 | 1 | Isegno | TestPoint | TestPoint:TestPoint_Pad_D1.0mm | test point
TP3 | 1 | Vout | TestPoint | TestPoint:TestPoint_Pad_D1.0mm | test point
TP4 | 1 | Vsegno | TestPoint | TestPoint:TestPoint_Pad_D1.0mm | test point
TP5 | 1 | Vref | TestPoint | TestPoint:TestPoint_Pad_D1.0mm | test point
TP6 | 1 | Iref | TestPoint | TestPoint:TestPoint_Pad_D1.0mm | test point
TP7 | 1 | VrefDAC | TestPoint | TestPoint:TestPoint_Pad_D1.0mm | test point
TP8 | 1 | Vsc1 | TestPoint | TestPoint:TestPoint_Pad_D1.0mm | test point
TP9 | 1 | Vsc2 | TestPoint | TestPoint:TestPoint_Pad_D1.0mm | test point
TP10 | 1 | Vsc3 | TestPoint | TestPoint:TestPoint_Pad_D1.0mm | test point
TP11 | 1 | Vsc4 | TestPoint | TestPoint:TestPoint_Pad_D1.0mm | test point
TP12 | 1 | Isc1 | TestPoint | TestPoint:TestPoint_Pad_D1.0mm | test point
TP13 | 1 | Isc3 | TestPoint | TestPoint:TestPoint_Pad_D1.0mm | test point
TP14 | 1 | Isc2 | TestPoint | TestPoint:TestPoint_Pad_D1.0mm | test point
TP15 | 1 | Isc4 | TestPoint | TestPoint:TestPoint_Pad_D1.0mm | test point
TP16 | 1 | ENC_A | TestPoint | TestPoint:TestPoint_Pad_D1.0mm | test point
TP17 | 1 | ENC_B | TestPoint | TestPoint:TestPoint_Pad_D1.0mm | test point
TP18 | 1 | ENC_SW | TestPoint | TestPoint:TestPoint_Pad_D1.0mm | test point
U1 | 1 | TL084 | TL084 | Package_SO:SOIC-14_3.9x8.7mm_P1.27mm | Quad JFET-Input Operational Amplifiers, DIP-14/SOIC-14/SSOP-14
U2 | 1 | OPA627AP | LM741 | Package_DIP:DIP-8_W7.62mm_LongPads | Operational Amplifier, DIP-8/TO-99-8
U3, U5 | 2 | 4066 | 4066 | Package_SO:SOIC-14_3.9x8.7mm_P1.27mm | Quad Analog Switches
U4 | 1 | ATmega32-16A | ATmega32-16A | Package_QFP:TQFP-44_10x10mm_P0.8mm | 16MHz, 32kB Flash, 2kB SRAM, 1kB EEPROM, JTAG, TQFP-44
U9 | 1 | MCP4912 | MCP4912 |  | 2-Channel 10-Bit D/A Converters with SPI Interface
U10 | 1 | LM4041LP-ADJ | LM4041LP-ADJ | Package_TO_SOT_THT:TO-92_Inline | Adjustable Precision Micropower Shunt Voltage Reference, TO-92
Y1 | 1 | 16Mhz | Crystal | Crystal:Crystal_SMD_HC49-SD_HandSoldering | Two pin crystal
