dario0603/power_supply/Alimentatore taratura manuale/LTspice/v 2.0/ALimentatore.asc

C1: cap; 220p
C2: cap; 100µ
C3: cap; 100n
D2: diode; 1N4148
D12: LED; NSPW500BS
Q1: npn; 2N3055
Q2: npn; 2N2222
Q3: npn; 2N2222
Q4: npn; 2N3055
R1: res; 1
R2: res; 10k
R3: res; 10k
R4: res; 0.1
R5: res; 0.1
R6: res; 5k
R7: res; 10k
R8: res; 1k
R9: res; 1p
R10: res; 1k
R11: res; 1p
Rload: res; 1k
U1: AD8030
U2: AD8030
V1: voltage; 25
V2: voltage; 10
V4: voltage; -15
Named nets: -V, Vin, 0, Vout, Vreg
.tran 0 1s 0 100m
Vout = Vreg*(R3/(R2+R3))
Iout <= (0.8V/R1)*(1+R6/R7)
