dario0603/power_supply/Relazione/Simulazioni/ALimentatore.asc

C1: cap; 10n
C6: cap; 10n
I1: load2; PULSE(10 0 0 1n 1n 0.1s 0.2s 10)
Q1: npn; 2N3055
Q2: npn; 2N2222
Q3: npn; 2N2222
Q4: npn; 2N3055
Q5: npn; 2N2222
R1: res; 1
R4: res; 0.1
R5: res; 0.1
R6: res; 1k
R7: res; 10k
R9: res; 4.7k
R10: res; 1.2k
R11: res; 1p
R12: res; 47k
R14: res; 10k
R15: res; 47k
Rshunt: res; 0.2
U3: AD712
U4: AD712
U5: AD712
V1: voltage; 25
V2: voltage; 4
V3: voltage; 5
V5: voltage; -12
V6: voltage; 12
Named nets: Vin, Vvreg, 0, Vireg, Vout+, V-, V+
.tran 0 1 0 0.01
Vout = Vvreg*(R9/R10)
I <= (Vireg/Rshunt)*(R14/R15) = Vireg*k
 
k è una costante data dal circuito esterno
e rappresenta R14/(R15*Rshunt)
Circuito esterno
