dario0603/power_supply/Relazione/Simulazioni/Raddrizzatore e filtro.asc

C1: cap; 14286µ
C2: cap; 14286µ
D1: diode; 1N4148
D2: diode; 1N4148
D3: diode; 1N4148
D4: diode; 1N4148
D5: diode; 1N4148
R1: res; 5
R2: res; 5
V1: voltage; SINE(0 25 50)
V2: voltage; SINE(0 25 50)
Named nets: 0
.tran 0 1s 0 10m
