dario0603/power_supply/Alimentatore taratura manuale/Kicad/Alimentatore JM/Alimentatore JM.kicad_pcb

## KiCad design Alimentatore taratura manuale/Kicad/Alimentatore JM/Alimentatore JM.kicad_pcb (2025-07-25)

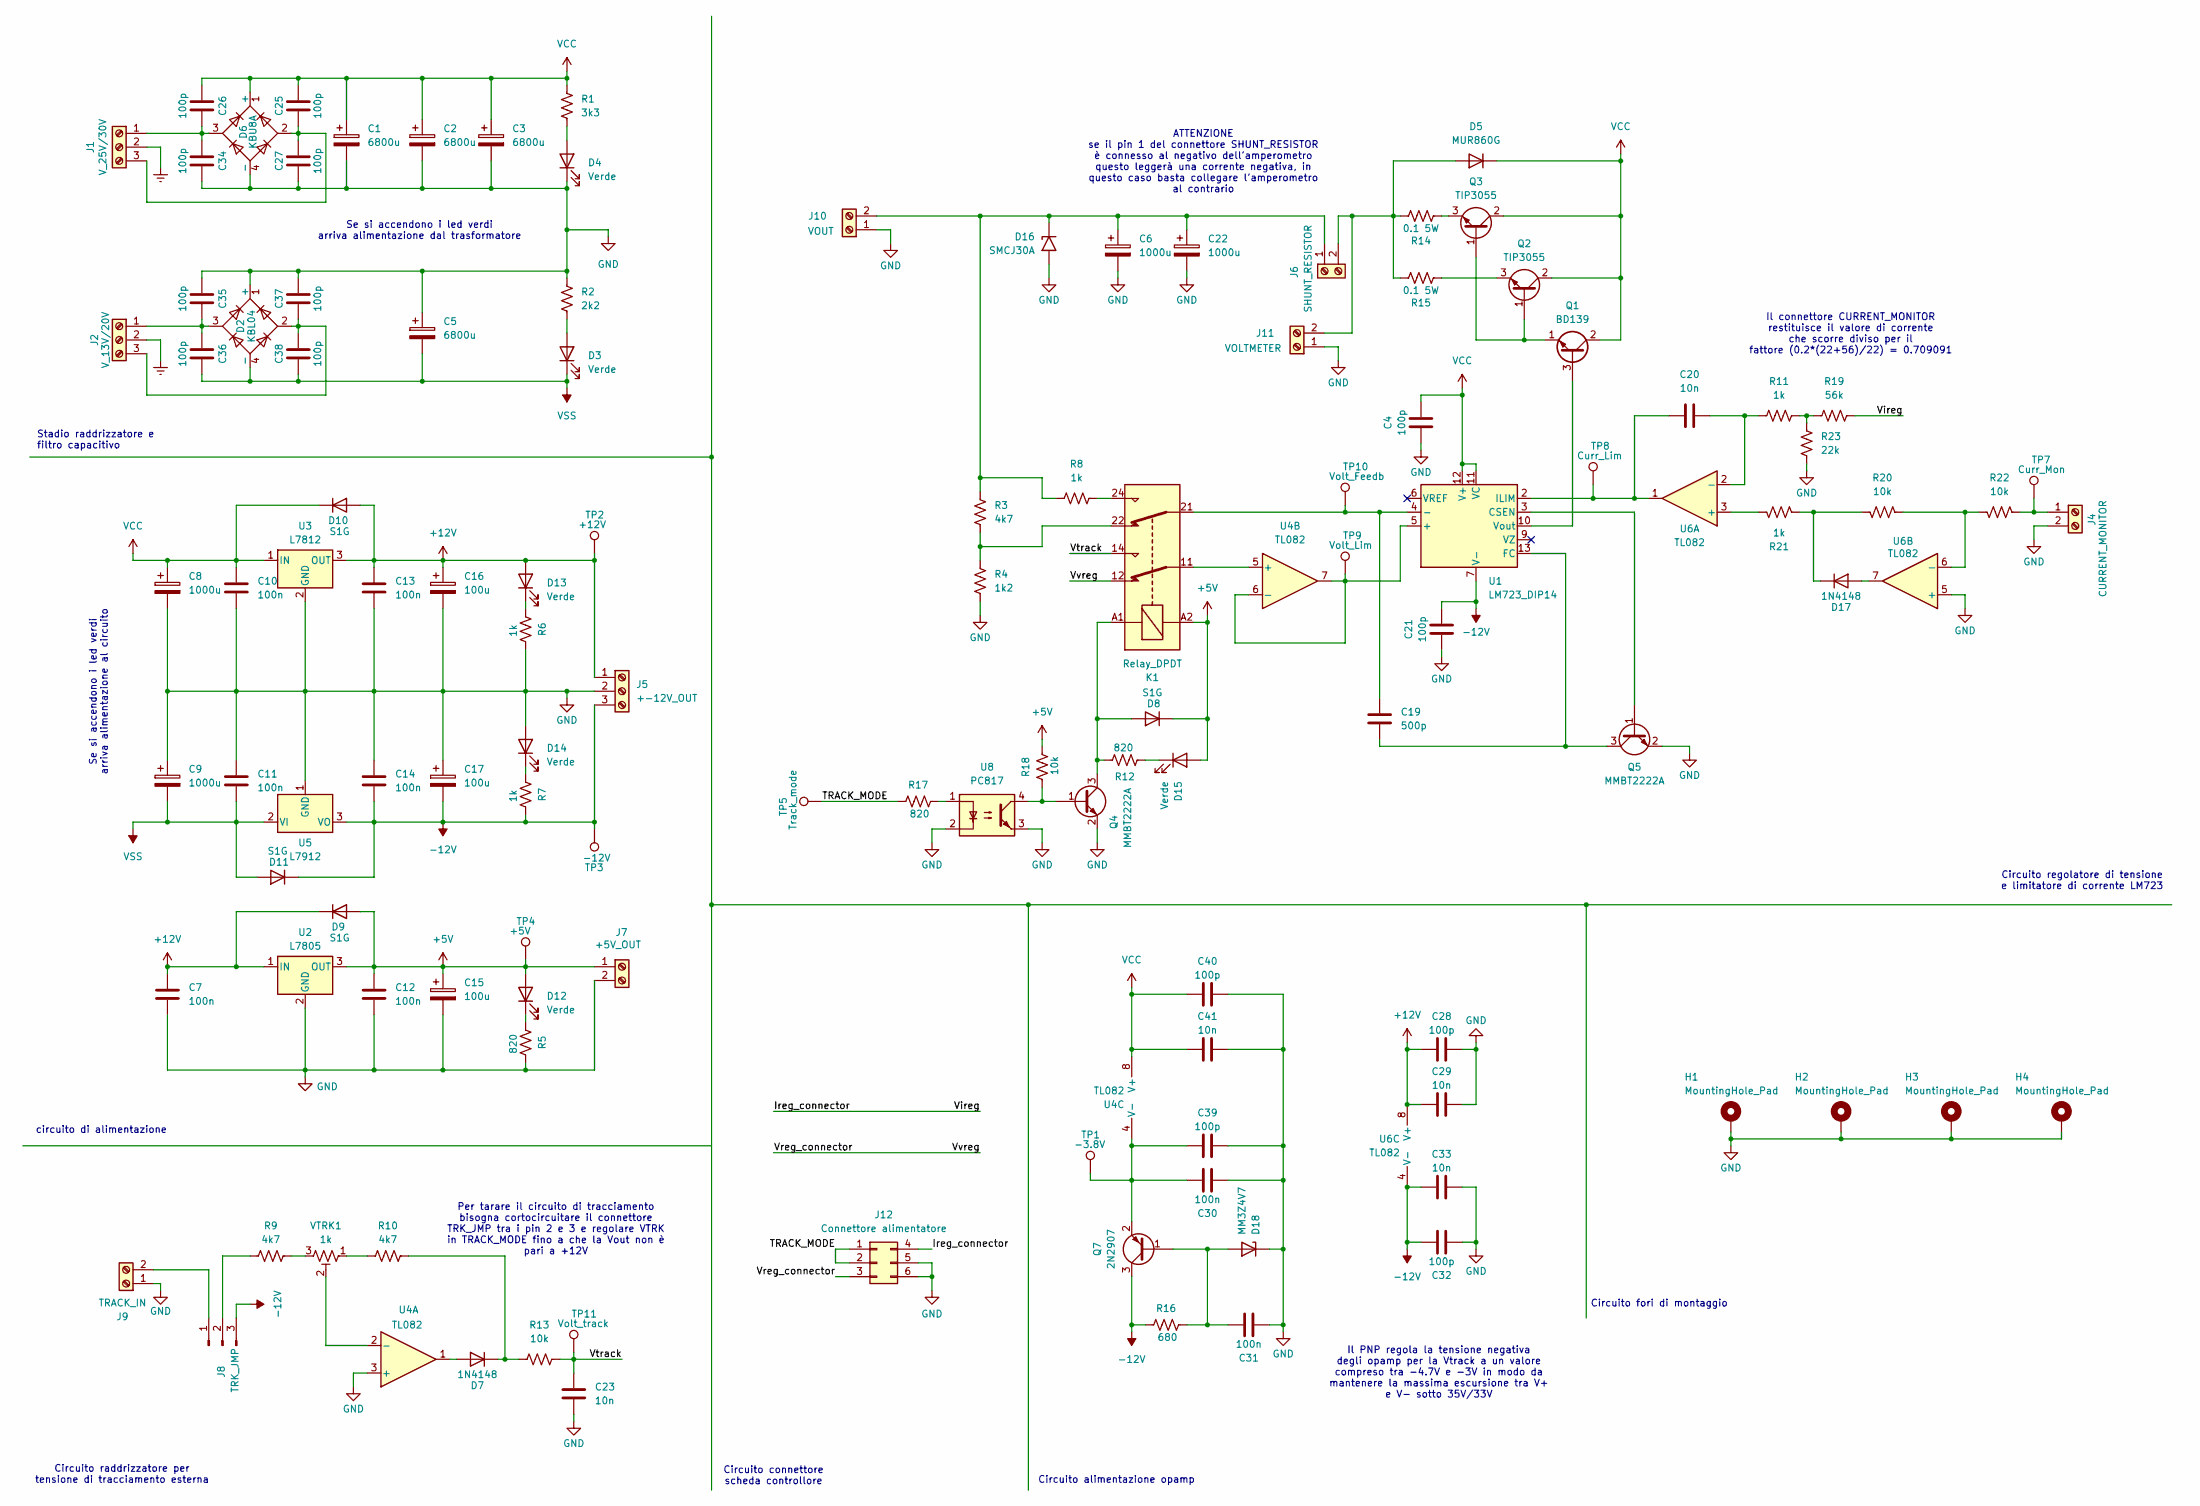
[picture p51: schematic Alimentatore JM.kicad_sch]

Parts:
C1, C2, C3, C5: 6800u; CP_Radial_D18.0mm_P7.50mm
C4, C21, C25, C26, C27, C28, C32, C34, C35, C36, C37, C38, C39, C40: 100p; C_0805_2012Metric_Pad1.18x1.45mm_HandSolder
C6, C8, C9, C22: 1000u; CP_Elec_8x10.5
C7, C10, C11, C12, C13, C14, C30, C31: 100n; C_0805_2012Metric_Pad1.18x1.45mm_HandSolder
C15, C16, C17: 100u; CP_Elec_8x10.5
C19: 500p; C_0805_2012Metric_Pad1.18x1.45mm_HandSolder
C20, C23, C29, C33, C41: 10n; C_0805_2012Metric_Pad1.18x1.45mm_HandSolder
D2: KBL04; Diode_Bridge_Vishay_KBL
D3, D4, D12, D13, D14, D15: Verde; LED_0805_2012Metric_Pad1.15x1.40mm_HandSolder
D5: MUR860G; TO-220-2_Vertical
D6: KBU8A; Diode_Bridge_Vishay_KBU
D7, D17: 1N4148; D_SOD-323F
D8, D9, D10, D11: S1G; D_SMA_Handsoldering
D16: SMCJ30A; D_SMC_Handsoldering
D18: MM3Z4V7; D_DO-35_SOD27_P7.62mm_Horizontal
H1, H2, H3, H4: MountingHole_Pad; MountingHole_3.2mm_M3_DIN965_Pad
J1: V_25V/30V; TerminalBlock_Phoenix_MKDS-1,5-3-5.08_1x03_P5.08mm_Horizont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
J2: V_13V/20V; TerminalBlock_Phoenix_MKDS-1,5-3-5.08_1x03_P5.08mm_Horizont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
J4: CURRENT_MONITOR; TerminalBlock_Phoenix_MKDS-1,5-2-5.08_1x02_P5.08mm_Horizont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
J5: +-12V_OUT; TerminalBlock_Phoenix_MKDS-1,5-3-5.08_1x03_P5.08mm_Horizont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
J6: SHUNT_RESISTOR; TerminalBlock_Phoenix_MKDS-1,5-2-5.08_1x02_P5.08mm_Horizont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
J7: +5V_OUT; TerminalBlock_Phoenix_MKDS-1,5-2-5.08_1x02_P5.08mm_Horizont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
J8: TRK_JMP; PinHeader_1x03_P2.54mm_Vertical
J9: TRACK_IN; TerminalBlock_Phoenix_MKDS-1,5-2-5.08_1x02_P5.08mm_Horizont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
J10: VOUT; TerminalBlock_Phoenix_MKDS-1,5-2-5.08_1x02_P5.08mm_Horizont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
J11: VOLTMETER; TerminalBlock_Phoenix_MKDS-1,5-2-5.08_1x02_P5.08mm_Horizont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
J12: Connettore alimentatore; PinHeader_2x03_P2.54mm_Vertical
K1: Relay_DPDT; Relay_DPDT_Finder_30.22
Q1: BD139; TO-126-3_Vertical
Q2, Q3: TIP3055; TO-218-3_Vertical
Q4, Q5: MMBT2222A; SOT-23
Q7: 2N2907; SOT-23
R1: 3k3; R_0805_2012Metric_Pad1.20x1.40mm_HandSolder
R2: 2k2; R_0805_2012Metric_Pad1.20x1.40mm_HandSolder
R3, R9, R10: 4k7; R_0805_2012Metric_Pad1.20x1.40mm_HandSolder
R4: 1k2; R_0805_2012Metric_Pad1.20x1.40mm_HandSolder
R5, R12, R17: 820; R_0805_2012Metric_Pad1.20x1.40mm_HandSolder
R6, R7, R8, R11, R21: 1k; R_0805_2012Metric_Pad1.20x1.40mm_HandSolder
R13, R18, R20, R22: 10k; R_0805_2012Metric_Pad1.20x1.40mm_HandSolder
R14, R15: 0.1 5W; R_Box_L14.0mm_W5.0mm_P9.00mm
R16: 680; R_0805_2012Metric_Pad1.20x1.40mm_HandSolder
R19: 56k; R_0805_2012Metric_Pad1.20x1.40mm_HandSolder
R23: 22k; R_0805_2012Metric_Pad1.20x1.40mm_HandSolder
TP1: -3.8V; TestPoint_Pad_D1.0mm
TP2: +12V; TestPoint_Pad_D1.0mm
TP3: -12V; TestPoint_Pad_D1.0mm
TP4: +5V; TestPoint_Pad_D1.0mm
TP5: Track_mode; TestPoint_Pad_D1.0mm
TP7: Curr_Mon; TestPoint_Pad_D1.0mm
TP8: Curr_Lim; TestPoint_Pad_D1.0mm
TP9: Volt_Lim; TestPoint_Pad_D1.0mm
TP10: Volt_Feedb; TestPoint_Pad_D1.0mm
TP11: Volt_track; TestPoint_Pad_D1.0mm
U1: LM723_DIP14; DIP-14_W7.62mm_LongPads
U2: L7805; TO-252-2
U3: L7812; TO-263-2
U4, U6: TL082; SOIC-8_3.9x4.9mm_P1.27mm
U5: L7912; TO-263-2
U8: PC817; DIP-4_W7.62mm_LongPads
VTRK1: 1k; Potentiometer_Runtron_RM-065_Vertical

Connections:
+5V: C12.1, C15.1, D8.1 (K), D9.2 (A), D12.2 (A), D15.2 (A), J7.1, K1.A2, R18.2, TP4.1, U2.3 (OUT)
+12V: C7.1, C13.1, C16.1, C28.1, C29.1, D9.1 (K), D10.2 (A), D13.2 (A), J5.1, TP2.1, U2.1 (IN), U3.3 (OUT), U6.8 (V+)
-12V: C14.2, C17.2, C21.2, C32.2, C33.1, D11.1 (K), J5.3, J8.3, Q7.3 (C), R7.2, R16.1, TP3.1, U1.7 (V-), U5.3 (VO), U6.4 (V-)
/Ireg_connector: J12.4, R19.2
/TRACK_MODE: J12.1, J12.2, R17.1, TP5.1
/Vreg_connector: J12.3, K1.12
/Vtrack: C23.1, K1.14, R13.2, TP11.1
Earth: J1.2, J2.2
GND: C1.2, C2.2, C3.2, C4.1, C5.1, C6.2, C7.2, C8.2, C9.1, C10.2, C11.1, C12.2, C13.2, C14.1, C15.2, C16.2, C17.1, C21.1, C22.2, C23.2, C27.1, C28.2, C29.2, C30.1, C31.1, C32.1, C33.2, C34.1, C35.2, C37.2, C39.2, C40.2, C41.2, D2.1 (+), D4.1 (K), D6.4 (-), D14.2 (A), D16.2 (A2), D18.1 (K), H1.1, H2.1, H3.1, H4.1, J4.2, J5.2, J7.2, J9.1, J10.1, J11.1, J12.5, J12.6, Q4.2 (E), Q5.2 (E), R2.1, R4.2, R5.2, R6.2, R23.1, U2.2 (GND), U3.2 (GND), U4.3 (+), U5.1 (GND), U6.5 (+), U8.2, U8.3
unnamed: D3.2 (A), R2.2
unnamed: D4.2 (A), R1.2
unnamed: D5.2 (A), J6.2, J11.2, R14.2, R15.2
unnamed: D7.2 (A), U4.1
unnamed: D7.1 (K), R10.2, R13.1
unnamed: D8.2 (A), K1.A1, Q4.3 (C), R12.2
unnamed: D12.1 (K), R5.1
unnamed: D13.1 (K), R6.1
unnamed: D14.1 (K), R7.1
unnamed: D15.1 (K), R12.1
unnamed: C6.1, C22.1, D16.1 (A1), J6.1, J10.2, R3.1, R8.1
unnamed: D17.2 (A), U6.7
unnamed: D17.1 (K), R20.2, R21.1
unnamed: C31.2, D18.2 (A), Q7.1 (B), R16.2
unnamed: C26.1, C34.2, D6.3, J1.1
unnamed: C25.1, C27.2, D6.2, J1.3
unnamed: C35.1, C36.2, D2.3, J2.1
unnamed: C37.1, C38.2, D2.2, J2.3
unnamed: J4.1, R22.1, TP7.1
unnamed: J8.1, J9.2
unnamed: J8.2, R9.1
unnamed: K1.22, R3.2, R4.1
unnamed: K1.24, R8.2
unnamed: Q1.3 (B), U1.10 (Vout)
unnamed: Q1.1 (E), Q2.1 (B), Q3.1 (B)
unnamed: Q2.3 (E), R15.1
unnamed: Q3.3 (E), R14.1
unnamed: Q4.1 (B), R18.1, U8.4
unnamed: Q5.1 (B), U1.3 (CSEN)
unnamed: C19.2, Q5.3 (C), U1.13 (FC)
unnamed: C30.2, C39.1, Q7.2 (E), TP1.1, U4.4 (V-)
unnamed: R9.2, VTRK1.3
unnamed: R10.1, VTRK1.1
unnamed: R11.2, R19.1, R23.2
unnamed: R17.2, U8.1
unnamed: TP9.1, U1.5 (+), U4.6 (-), U4.7
unnamed: C19.1, K1.21, TP10.1, U1.4 (-)
unnamed: C20.1, TP8.1, U1.2 (ILIM), U6.1
unnamed: U4.2 (-), VTRK1.2
unnamed: K1.11, U4.5 (+)
unnamed: R21.2, U6.3 (+)
unnamed: C20.2, R11.1, U6.2 (-)
unnamed: R20.1, R22.2, U6.6 (-)
VCC: C1.1, C2.1, C3.1, C4.2, C8.1, C10.1, C25.2, C26.2, C40.1, C41.1, D5.1 (K), D6.1 (+), D10.1 (K), Q1.2 (C), Q2.2 (C), Q3.2 (C), R1.1, U1.11 (VC), U1.12 (V+), U3.1 (IN), U4.8 (V+)
VSS: C5.2, C9.2, C11.2, C36.1, C38.1, D2.4 (-), D3.1 (K), D11.2 (A), U5.2 (VI)

Notes on the sheet:
Per tarare il circuito di tracciamento bisogna cortocircuitare il connettore TRK_JMP tra i pin 2 e 3 e regolare VTRK in TRACK_MODE fino a che la Vout non è pari a +12V
circuito di alimentazione
Circuito connettore scheda controllore
Circuito fori di montaggio
Stadio raddrizzatore e filtro capacitivo
Circuito alimentazione opamp
Se si accendono i led verdi arriva alimentazione dal trasformatore
Circuito regolatore di tensione e limitatore di corrente LM723
Il connettore CURRENT_MONITOR restituisce il valore di corrente che scorre diviso per il fattore (0.2*(22+56)/22) = 0.709091
Il PNP regola la tensione negativa degli opamp per la Vtrack a un valore compreso tra -4.7V e -3V in modo da mantenere la massima escursione tra V+ e V- sotto 35V/33V
Se si accendono i led verdi arriva alimentazione al circuito
Circuito raddrizzatore per tensione di tracciamento esterna
ATTENZIONE se il pin 1 del connettore SHUNT_RESISTOR è connesso al negativo dell'amperometro questo leggerà una corrente negativa, in questo caso basta collegare l'amperometro al contrario

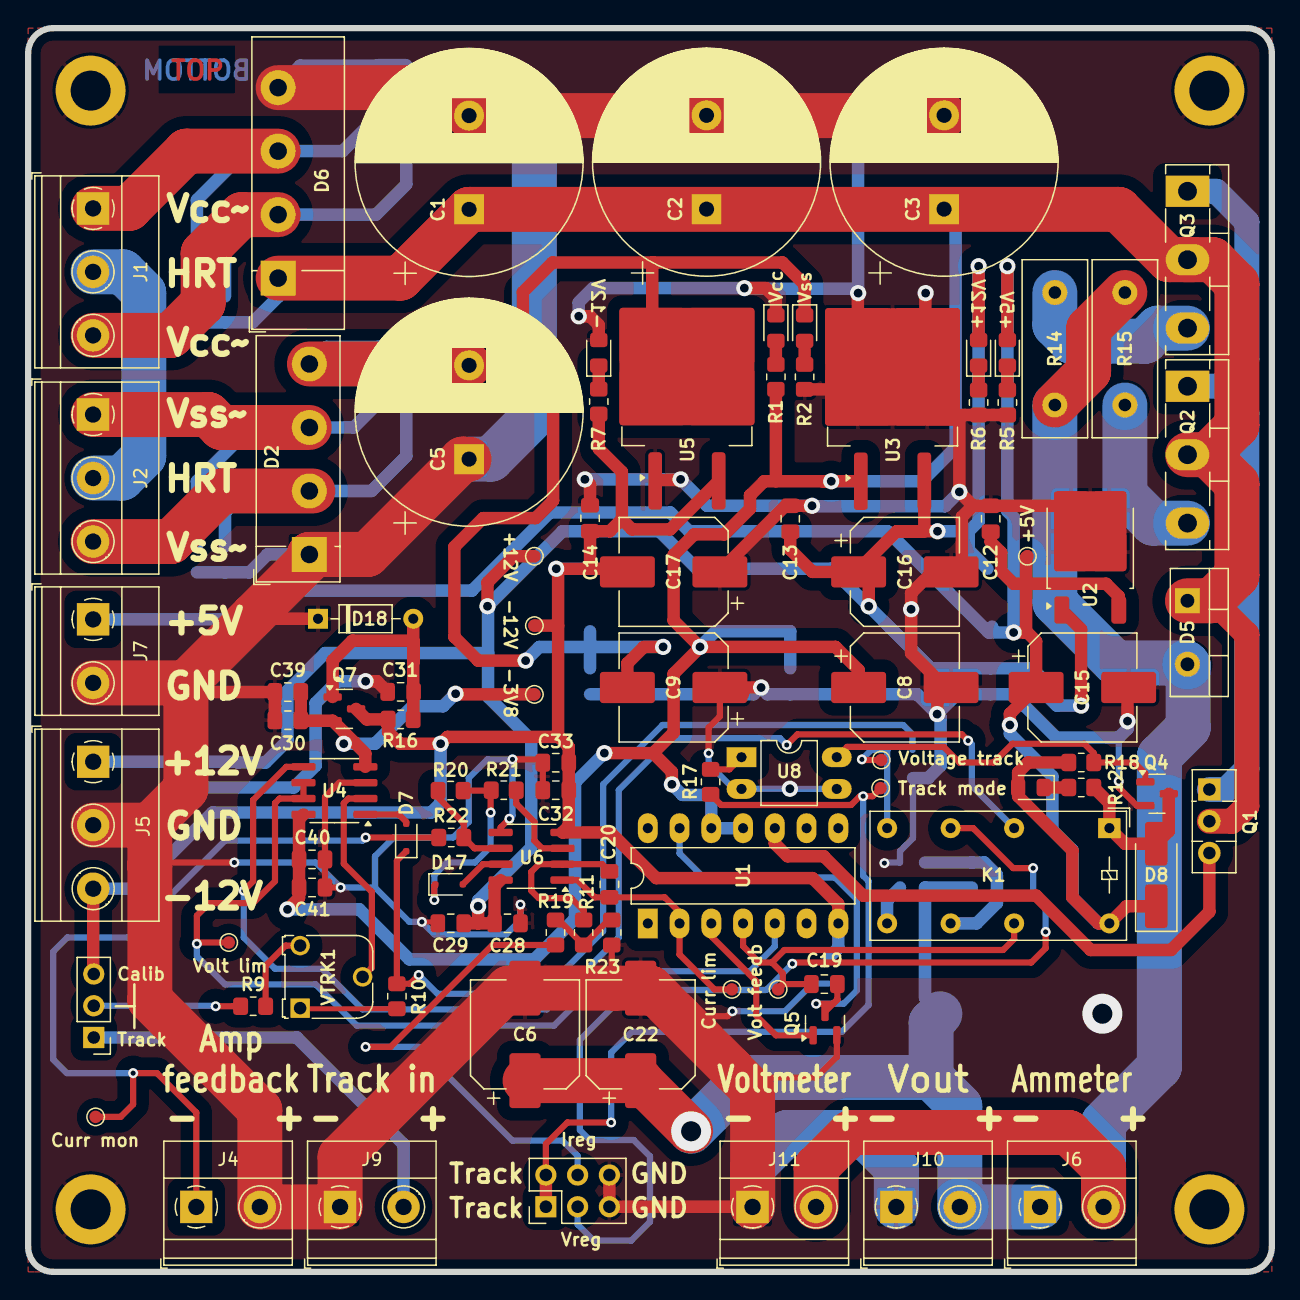
[picture p52: board Alimentatore JM.kicad_pcb from above]

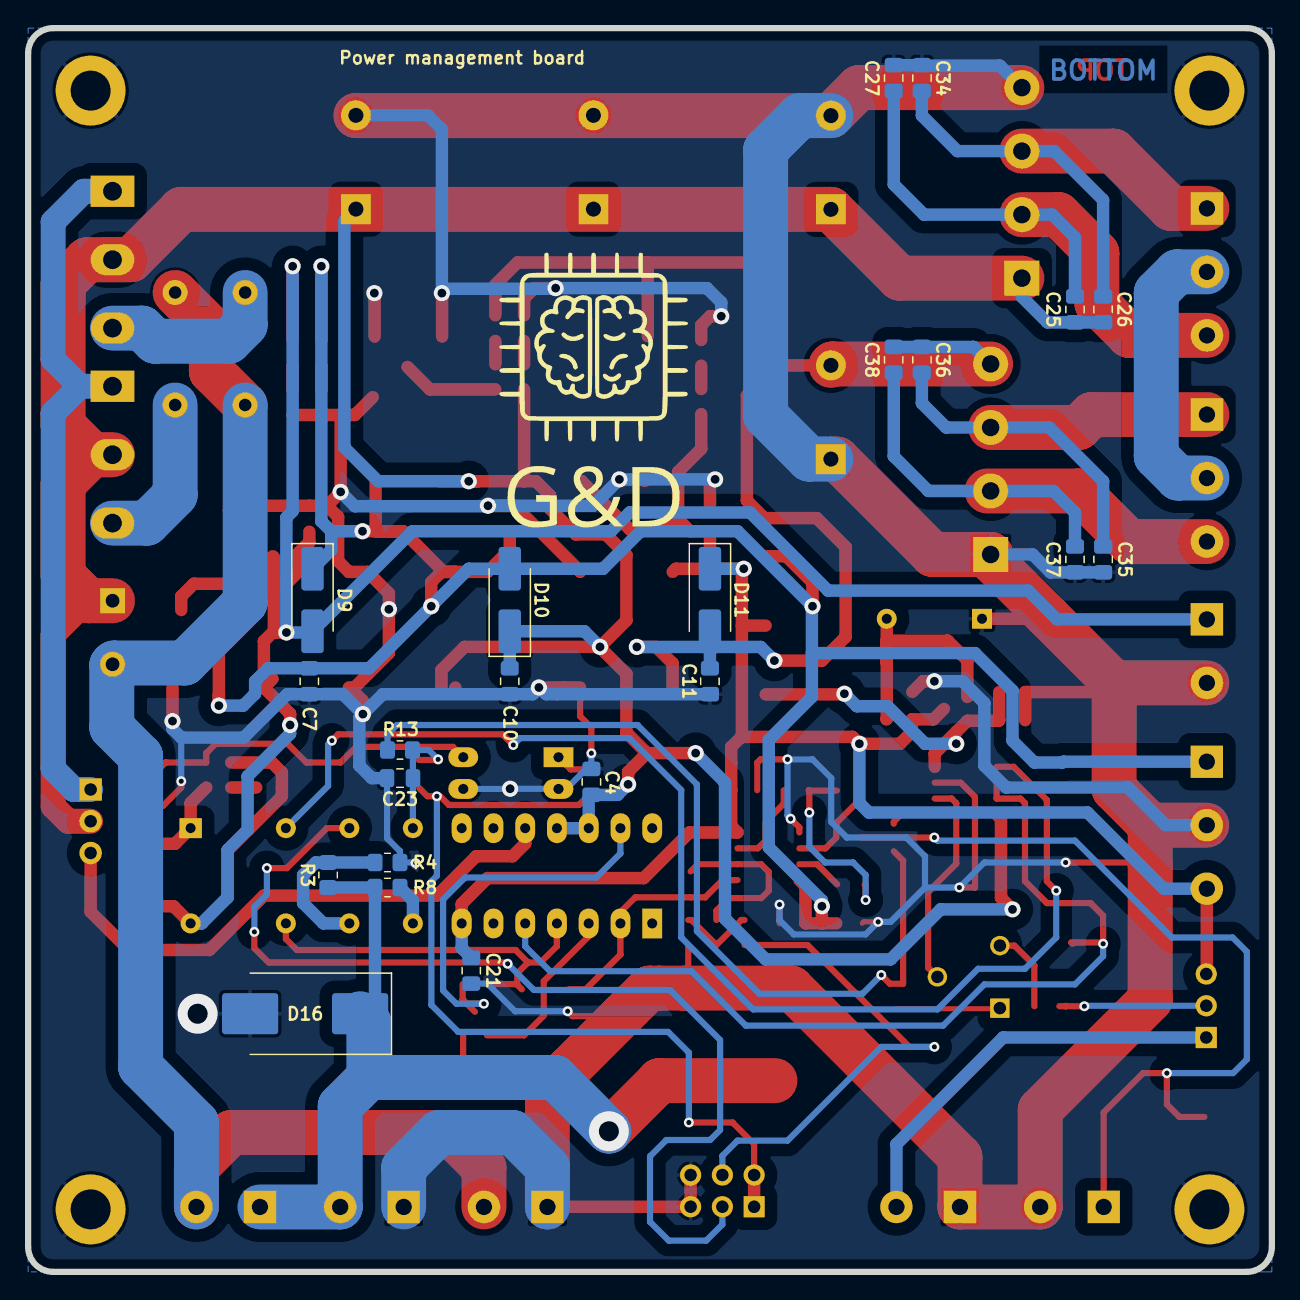
[picture p53: board Alimentatore JM.kicad_pcb from below]

Board: 2 copper layers, 99.5 x 99.5 mm, 119 parts (22 on the bottom side), 54 nets.
