dario0603/power_supply/(commit log)

2026-10-19 Add README for Linear Power Supply project
    Added detailed project overview, objectives, circuit architecture, and documentation for the Linear Power Supply project.
2026-10-19 Enhance README with detailed voltage specs and LTspice info
    Updated the README to clarify the specifications of negative voltages created with Zener diodes and added sections for LTspice simulations, including analysis of ripple, filtering, step response, and ramp response.
2026-10-19 Enhance README with project badges
    Added badges for KiCad, LTspice, and project status to README.
